jingchunqi09-sudo/Complexmusic/hardware/pinout.md

# 引脚表定案过程（3.5.6 → 3.5.10）

> 这份文档记录**唯一一个查不到的事实**（排线压接方向）是怎么靠实测反推出来的，
> 以及为什么 3.5.8 那份"上拉自洽性"论据不成立。以后不要再重复这三轮试错。

---

## 一、文件里能确定的部分（有几何验证，不是猜）

### 1. 转接板 U1（ESP32 30 针座）pad → GPIO

来自 `U1` 符号的 Pin Name，并用交叉项验证：

| pad | 9 | 10 | 15 | 17 | 18 | 19 | 20 | 21 | 22 | 23 | 24 | 25 |
|---|---|---|---|---|---|---|---|---|---|---|---|---|
| 引脚名 | D18 | D19 | D23 | VP | VN | D34 | D35 | D32 | D33 | D25 | D26 | D27 |
| GPIO | 18 | 19 | 23 | 36 | 39 | 34 | 35 | 32 | 33 | 25 | 26 | 27 |

**交叉验证**：`pad6=ESP_RX`、`pad7=ESP_TX` 落在 GPIO16/17，与本工程 UART2 完全一致；
`pad11/14=IMU_SDA/SCL` 落在 GPIO21/22，与 I2C 一致。列序可信。

### 2. 网络 → U1 pad（有走线几何验证）

PCB 段 `PAD_NET` 按 `COMPONENT` 顺序切分后，再用 `LINE` 走线端点坐标反查焊盘：

| 网络 | U1 pad | 几何验证 |
|---|---|---|
| `ENC1_A` | 9 | 走线端点 `(-50,-134)` 与 pad9 坐标**误差 0.0** |
| `ENC1_SW` | 19 | 端点 → pad19，误差 9.4（同一焊盘内） |
| `ENC4_SW` | 18 | 端点 → pad18，误差 0.8 |
| `ENC3_A` | H9 pad7 | 端点 `(450,-265)` 与 H9.pad7 旋转后坐标**误差 0.0** |

于是 `网络 → GPIO`：`ENC1_A=18 ENC1_B=19 ENC1_SW=34 / ENC2_A=23 B=25 SW=35 /
ENC3_A=26 B=27 SW=36 / ENC4_A=32 B=33 SW=39`。

### 3. 面板 U11 与转接板 H9 的针序（`PAD_NET`）

```
U11 pin1..14 : GND  1A   1B   1SW  2A   2B   2SW  3A   3B   3SW  4A   4B   4SW  GND
H9 pad1..14  : GND 4SW  4B   4A   3SW  3B   3A   2SW  2B   2A   1SW  1B   1A   GND
```

**H9 pad k 的网络名 = U11 pin 15−k**（整组反序）。

---

## 二、唯一查不到的事实：排线怎么压

两种 HC-2510 带防呆，排线只能是 1-1 或 1↔14 两种之一，**两个工程文件里都没有这个信息**。

### 3.5.8 用了"上拉自洽性"来判，这个论据是错的

当时的推理是：转接板 `R1..R4` 只上拉了 `ENCn_SW` 四个网络，而 GPIO34/35/36/39 没有内部上拉，
所以"同向排线让这四个脚正好落在有外部电阻的网络上，反序会出现 4 个悬空脚"。

**实际算一遍就知道两种接法完全一样**：`ENCn_SW` 四个网络对应的 GPIO 就是 34/35/36/39，
它们与排线方向**无关**；而 H9 与 U11 是整组反序，所以无论 1-1 还是 1↔14，
"面板的四个 SW" 都落到这四个网络上。**这条判据不区分任何东西。**

---

## 三、真正能判的：3.5.5 那版的实板现象

3.5.5 的表是 `ENC1=4/5/13, ENC2=18/19/21, ENC3=22/23/25, ENC4=26/27/32`，
其中 **4/5/13 根本没连任何 ENC 网络**（纯悬空），**21/22 是 I2C 的 IMU_SDA/SCL**。

把这个表分别套到两种排线上：

| 3.5.5 的组 | 同向 1-1 实际接到 | 反序 1↔14 实际接到 |
|---|---|---|
| ENC1 (4/5/13) | 三个死脚 | 三个死脚 |
| ENC2 (18/19/21) | 旋钮**4** 的 SW / B | 旋钮**1** 的 A / B |
| ENC3 (22/23/25) | 死脚 / 旋钮**3** 的 SW / B | 死脚 / 旋钮**2** 的 A / B |
| ENC4 (26/27/32) | 旋钮**2** 的 SW / B / 旋钮**1** 的 SW | 旋钮**3** 的 A / B / 旋钮**4** 的 B |

用户当时的原话：

> 有一个可以调节音色，第二个旋钮旋转一直会换弦，第三个调节的混响，第四个一直在旁路和混响那里切换

- **反序**：旋钮1→音色、旋钮2→换弦、旋钮3→混响、旋钮4→旁路 —— **与 1/2/3/4 的说法逐条对上**
- **同向**：旋钮1→旁路、旋钮2→混响、旋钮3→换弦、旋钮4→音色 —— **完全倒过来**

两条都没法解释"ENC1 全死"这一点（因为 4/5/13 在两种接法下都是悬空），
所以用户描述的四个旋钮，实际是 ENC2/3/4 加上"ENC4 被两个旋钮共用"的错觉。
**但功能顺序只有反序能对上**，这是唯一能判的硬证据。

---

## 四、结论（3.5.10 现行）

排线是 **反序 1↔14**，表为：

| 编码器 | A | B | SW |
|---|---:|---:|---:|
| ENC1（最左，音量） | 18 | 19 | 34 |
| ENC2（音色） | 23 | 25 | 35 |
| ENC3（定弦/换弦） | 26 | 27 | 36 |
| ENC4（最右，混响） | 33 | 32 | 39 |

`ENC4` 的 A/B 按用户核对结果为 33/32（符号读出是 32/33，只影响旋转方向）。

---

## 五、10 秒定死方法（3.5.10 新增自检）

网页新增「**面板接线自检**」卡片，显示 12 个 GPIO 的累计边沿数：

1. 点「清零后监视」
2. 转**最左**那颗旋钮
3. 看哪两个数在涨：
   - **18 / 19** → 反序（当前表正确）
   - **39 / 33** → 同向，需要把表整组换成 `39/33/32, 36/27/26, 35/25/23, 34/19/18`
4. 再按一下最左旋钮，看哪个脚掉到 0：
   - **34** → 反序
   - **32** → 同向

这一步跑完，这个变量就永远定死了，不需要再猜。
