jingchunqi09-sudo/Complexmusic/docs/left-hand-latency.md

> **来源（编者注）**
>
> 本文档原为 `左手选品参考代码/工程/docs/延迟上限_采样策略_琴弦材料_评估_20261027.md`，
> 该目录未随包分发。
>
> **为什么值得收进开源包**：这是左手采集链少见的定量分析——
> 5 ms 时隙的下限由 78 B 包的 UART 时间钉死（3.386 ms，占 68%）、
> 300→450 轮只涨 1.8 dB 而不降延迟、手掌 117 pF 对目标 3 pF 的 ~40 倍干扰比、
> 以及「换琴弦材料优先级最低」的反直觉结论。
> 这些数字是 `config/left_hand_detection.json` 取值的上游依据。
>
> 文中 `/d/left_hand_build` 为作者本地路径，仅作文档引用，不代表包内结构。

# 延迟上限、采样策略与琴弦材料 —— 评估报告

日期：2026-10-27
对应固件：`/d/left_hand_build`（46 kHz 载波 / 5 ms 时隙 / 230400 / LH/v2 78 字节包）

---

## 0. 结论摘要

| 问题 | 结论 | 关键数字 |
|---|---|---|
| 5 ms 时隙还能不能降 | **测试期不能**（下限由 78 B 包的 UART 时间钉死）；**判定进 FPGA 后能**，那时下限改由信噪比决定 | 78 B @230400 = **3.386 ms**，已占 5 ms 的 68% |
| 间隙里多采几轮 | **5 ms 里已经采满 300 轮、无空转**；但密度还能提 1.5×（SCLK 12.5 MHz）。**多采只涨信噪比，不降延迟** | 300→**450 轮**仅 +1.8 dB；延迟仍是 5~20 ms |
| FPGA 处理 + 选择性发送 | **方向完全正确**：终态不回 PC 后 UART 约束消失，时隙改由 SNR 决定。这一步要做的是把 `fret_map.py` 搬进 RTL | 包 78 B→16 B；测试期时隙下限 3.39→0.69 ms |
| 换琴弦材料（漆包线等） | **优先级最低，且漆包线有反向风险**。干扰主路径是手掌→背面的电容耦合，与弦材料无关 | 手掌 117 pF vs 目标 3 pF，干扰比信号强 ~40× |

**一句话**：先修模拟前端（背面屏蔽 → 弦高 → 驱动幅度），把信号从噪声底抬起来；再把判定下沉到 FPGA 并发 16 B 结果包；最后才考虑频分并行把延迟再砍一半以上。现在换弦材料不解决主要矛盾。

---

## 1. 延迟预算的真相

### 1.1 现状时间线（5 ms 时隙版）

```
时隙 k（5 ms）
├ 0 µs      ── 切弦（break-before-make 60 ns 空白）
├ 0-100 µs  ── SETTLE_TICKS=5000，ADC 不动
├ 100 µs-5 ms ── ADC 从 ch0 连续扫到 ch7，循环，共 300 帧
│                每帧 816 clk = 16.32 µs（16 通道顺序，每通道 102 clk）
├ 5 ms      ── slot_end，结算 mag[0..15]，打包发 78 B
└ 5 ms-8.39 ms ── UART 发完（与下一时隙的采集并行）
```

四弦分时 → 一轮 = 4 × 5 ms = **20 ms**。判定在 PC 端、当拍出结果，算法本身耗时 0.113 ms 可忽略。

所以按下到出结果的延迟 = **等待时隙 0~15 ms + 5 ms 累加 ≈ 5~20 ms**（平均 12.5 ms）。
用户实测"5 ms 也还行"，符合这个量级。

### 1.2 三重约束，按严重度排序

| # | 约束 | 当前值 | 怎么破 |
|---|---|---|---|
| 1 | **UART 包长**（仅测试期成立） | 78 B × 10 bit / 230400 = **3.386 ms** | 压包，或用更高波特率；终态不回 PC 后此约束消失 |
| 2 | **分时四弦** | 轮询 = 4 × 时隙 | 频分并行（每弦不同载波，但有前置条件，见 3.1） |
| 3 | **累加轮数 → 信噪比** | 300 轮（每相 75 轮） | 提高 SCLK（+52%）或换同时采样 ADC（×3~10） |

第 3 条容易被忽略但最要命：**缩短时隙 = 减少累加帧数 = 噪声按 √N 变差**。当前解调幅度空闲基线中位数只有 8~11（满量程 4095，约 −52 dBFS），说明信号链本来就紧，没有余量再牺牲平均。

---

## 2. 「5 ms 这么长的激励时间里，为什么不能多采几轮？」

先把三件被混在一起的事拆开：

| 事 | 由什么决定 | 影响什么 |
|---|---|---|
| **时隙长度** | 激励切换节奏（`EXC_SLOT_TICKS`） | **只决定延迟** |
| **时隙内的轮数** | 一轮时长（帧周期）× 可用时间 | **只决定信噪比** |
| **一轮时长** | 每轮要串行读几个通道 × SCLK 周期 | 同时影响上面两者 |

### 2.1 现状：5 ms 里确实已经采满了，但密度还能提

```
5 ms 时隙 = 100 µs 建立 + 300 × 16.32 µs（无空转）+ 0
100 µs + 300 × 16.32 µs = 4.996 ms
```

`adc_state` 在 `exc_count >= SETTLE_TICKS` 之后就进 A_XFER / A_HOLD / A_GAP 自循环，只有 `slot_end` 才停 —— 所以**没有空闲间隙，但也没到物理上限**。我上一轮说"300 帧是物理上限"是错的：那是**当前 SCLK 下**的上限。

一轮 16.32 µs 的构成：8 个通道时隙 × 102 clk，每个通道时隙 = 16 bit × 2 翻转 × 3 clk + HOLD 3 + GAP 3。瓶颈是 **8 个通道必须串行读完**（16 路靠 2 片 ADC128S102 同时转换，每槽 2 路，8 槽覆盖 16 路）。

### 2.2 轮数上限：三档提速

| 档 | 做法 | 一轮时长 | 5 ms 内轮数 | SNR 变化 |
|---|---|---|---|---|
| 0 现状 | SCLK 8.33 MHz | 16.32 µs | 300 | 1.00× |
| **1 免费** | `ADC_HALF_DIV 3→2`，SCLK **12.5 MHz** | 10.88 µs | **450** | **+1.8 dB** |
| 2 换 ADC | 16 路同时采样（AD7606 等），一轮 1 µs 级 | ~1-5 µs | 1000~5000 | 大幅 |
| 3 加片 | 更多 ADC128S102 并行 | 不变 | 不变（只加通道数） | 无 |

档 1 的代价：四相相干条件重解，载波只能取 `CARRIER_HALF=64`（390.6 kHz）或 `1088`（23.0 kHz）；12.5 MHz 是 50 MHz 时钟整数分频下能到的最高合法值（`ADC_HALF_DIV=1` 会到 25 MHz，超手册 16 MHz 上限）。

**注意档 1 的收益只有 +1.8 dB。** 因为噪声是 √N 关系，300→450 是 √1.5 = 1.22 倍幅度。而"降弦高 1.5→0.9 mm"是 +4.4 dB，"背面加接地屏蔽"可能消掉 39 倍共模源（+31 dB）。这就是为什么多采几轮不是当务之急。

### 2.3 关键澄清：多采几轮不降延迟

这一点最容易误会。**时隙末才结算一次发布**，所以：

```
延迟 = 等待时隙（0~3×时隙）+ 时隙（固定）
5 ms 时隙 → 5~20 ms，采 300 轮还是 3000 轮，都一样
```

想在 5 ms 窗口里多采，提高的是"这个结论有多可信"，不是"这个结论有多快出来"。**要跟手，必须缩时隙；缩时隙就要牺牲轮数。**两者是同一根杠杆的两端。

唯一能同时改善的办法是**让一轮变短**（档 2）：2 ms 时隙 + 每轮 1 µs = 1900 轮，既比现在的 300 轮多 6 倍，延迟还只有现在的 40%。这才是"并行采样"的真正价值。

### 2.4 终态（不回 PC）时隙下限要重新定义

用户已明确：**串口只是测试用的，最终结果留在 FPGA**。那么第 1.2 节里"UART 是硬约束"只在测试期成立。终态下：

```
时隙下限 = 建立时间(100 µs) + 最少轮数 × 一轮时长
UART 不参与，判定延迟也不参与（FPGA 内当拍出结果）
```

这带来一个重要结论：**测试期先别急着缩时隙**。现在 5 ms 之所以"还行"，是因为它刚好卡在 78 B @230400（3.39 ms）之上——再往下就会丢包，跟 SNR 无关。等判定进 FPGA、只发 16 B 结果包之后，时隙才可以按 SNR 的真实需要去选，而不是按串口带宽去选。

对应地，"FPGA 处理多轮采样、选择性发送"要做的事是：

1. **轮数不变**（还是 300 轮/时隙），在 FPGA 里把 300 轮合成 I/Q 幅度 —— 这已经是现在 `acc0..acc3` 在做的；
2. **判定也搬进 FPGA**：上电基线 + 逐极 Δ + 邻道比 + 阈值，输出"哪根弦第几品"；
3. **只在实际状态变化时**输出 8~16 B，或者干脆只点 LED，串口退化成调试口。

所以你说的这套东西，**架构上就是现在这套，只是把 `fret_map.py` 搬到 RTL 里**。它不会改变采样密度，但会解放时隙下限、去掉 PC 环节，并让"想采多少轮就采多少轮"变成真正可调的参数。

---

## 3. 降时隙的可行组合（含代价）

帧数 = (时隙 − 100 µs) / 16.32 µs；噪声倍数 = √(75 / 每相帧数)，以 5 ms 版为 1.00。

| 方案 | 时隙 | 包长/波特率 | UART 占用 | 帧数/每相 | 噪声倍数 | 轮询 |
|---|---|---|---|---|---|---|
| **现状** | 5 ms | 78 B @230400 | 68% | 300 / 75 | 1.00× | **20 ms** |
| A1 提波特率 | 3.5 ms | 78 B @460800 | 48% | 208 / 52 | 1.20× | 14 ms |
| A2 提波特率 | 2.5 ms | 78 B @460800 | 68% | 147 / 37 | 1.43× | 10 ms |
| **B1 结果包** | 2 ms | 16 B @230400 | 35% | 116 / 29 | 1.61× | **8 ms** |
| **B2 结果包** | 1.5 ms | 16 B @230400 | 46% | 86 / 22 | 1.87× | **6 ms** |
| B3 结果包 | 1 ms | 16 B @230400 | 69% | 55 / 14 | 2.33× | 4 ms |
| B3′ +ADC 提速 | 1 ms | 16 B @230400 | 69% | 82 / 21 | 1.94× | 4 ms |
| **C 频分并行** | 2 ms | 16 B @460800 | 17% | 116 / 29 | 1.61× | **2 ms**（有前置条件，见 3.1） |

读法：

- **A 组是纯参数改动**，不动协议、不动 PC 端，风险最低，但只能到 10 ms。
- **B 组是用户想的那条路**：判定进 FPGA，只发结果。16 B 结构建议：
  `4C 48 | ver=03 | seq | exc[3:0] | pad_hit[3:0]+conf | delta[11:0] | 邻居比[7:0] | crc16` → 刚好 16 B = 0.69 ms @230400。
  算法侧只需要"上电基线（4 弦 × 16 极 × 12 bit，768 bit BRAM）+ 逐极 Δ + 邻道比 + 阈值"，资源估算 2500~3500 LUT（当前 9935/59904，完全装得下）。
- **C 组理论上能同时拿到"20 ms 窗口 + 2 ms 延迟"**：四弦各用一个载波，同时激励、同时解调，轮询 = 1 × 时隙。**但它有一个前置条件，见 3.1，在未验证前不作为推荐路线。**

**推荐路线：B2（1.5 ms / 6 ms 轮询）先落地**，噪声只掉 1.87×，且保留了把 B 改成 C 的接口。

### 3.1 C 组（频分并行）的两个门槛

**门槛一（致命，先前已被否决过一次）**：分时方案里"哪根弦"靠**电学隔离**——只有一根弦被驱动，其余接地。一旦改成四弦同时驱动，判据就降级成"频率选择性"，隔离度从 −∞ 变成由**弦间桥接阻抗**决定。而用户实测"按中间两根弦最差、中间弦两侧都有邻居最严重"，恰恰说明**手在桥接相邻弦**。桥接一旦成立，1 号弦的载波会经手指灌进 2 号弦，2 号弦的解调结果里混着邻弦信号 —— 频分并行在这种条件下会直接失去分弦能力。

所以 C 组的**前提条件**是：先通过弦间绝缘（Kapton 隔片 / 局部护套 / 弦距拉开）把弦间直流与低频阻抗提到足够高，并且用数据集验证"单弦桥接量"可接受。这个前提不成立，C 组不能用，只能留在 4×时隙的框架里。

**门槛二（工程性）**：ADC 每通道的等效采样率恰好等于帧率 **61.27 kHz**，所以载波必须取帧率的整数倍才能在 N 帧上正交（矩形窗 DFT，整数 bin 之间严格正交，无泄漏）：

- 可用集合 `{1,2,4,8} × 61.27 kHz` = 61.3 / 122.5 / 245.1 / 490.3 kHz —— **谐波互不重叠**（方波只有奇次谐波，这个集合的奇次倍集两两不相交）。
- 不能用的：`{1,2,3,4}` —— 1 号弦的 3 次谐波正好落在 3 号弦的 bin，串扰 −9.5 dB，致命。
- 490 kHz 已在 TIA 极点（482 kHz）之上，会衰减 3 dB 并抬高辐射耦合，实际可能要退成 **2 弦并行 + 2 时隙**（轮询 = 2 × 时隙 = 4 ms，C 组一半的收益，但只增加 2× 解调资源、载波只用 61/122 kHz）。

代价：解调资源 ×4（16 ch × 4 相 × 4 频 = 256 个 24 bit 累加器），以及激励端方波的高次谐波会经弦-极非线性（手指接触的金属-氧化物接触）产生互调，落点是待验证项。

---

## 4. 琴弦材料：定量分析

### 4.1 三个可能的动机，逐个算

**(a) 让弦-铜极耦合更强 —— 无收益，甚至略负**

漆层 40 µm、εr≈3.5，等效把间距 d 缩短 40 µm 又拉长 40/3.5≈11 µm，净变化 ≈ −29 µm。若原间距 1.5 mm，C 变化 **+2%**。噪声底级别的差异。

**(b) 切断手的欧姆通路 —— 取决于手接触电阻，可能反向**

漆包线把"裸线欧姆接触"换成"串联介质电容"。手指压弦接触面积按 5 mm × 1.2 mm、漆层 40 µm 估：

```
C_enamel = ε0·εr·A/d = 8.854e-12 × 3.5 × 6.0e-6 / 40e-6 ≈ 4.65 pF
Z @46 kHz  = 1/(2π·46k·4.65p) ≈ 744 kΩ
Z @260 kHz = 1/(2π·260k·4.65p) ≈ 132 kΩ
```

判据很干脆，**用万用表量一下手指压弦时弦到人体的直流电阻**：

| 实测手-弦接触电阻 | 换漆包线后干扰 | 结论 |
|---|---|---|
| < 100 kΩ（湿手、用力按） | 744 kΩ ≫ 原值 → 干扰降 7~70× | **有显著收益** |
| ≈ 500 kΩ ~ 1 MΩ（干手、轻按） | 744 kΩ ≈ 原值 → 基本不变 | 无收益 |
| 干手 + 高载波（260 kHz） | 132 kΩ < 1 MΩ → 干扰反而 +7× | **反向，别换** |

也就是说：漆包线是不是好主意，**完全取决于这个还没测的数**。这是第一个该去量的东西。

**(c) 降低弦的 AC 电阻（趋肤效应）—— 46 kHz 下可忽略，260 kHz 下才有意义**

```
δ_钢(μr≈100, 46k)  ≈ 91 µm     R_ac/R_dc ≈ 1.1
δ_铜(46k)          ≈ 304 µm    R_ac/R_dc ≈ 0.8（全截面导通）
δ_钢(260k)         ≈ 38 µm     R_ac/R_dc ≈ 2.6
```

46 kHz 下钢弦和铜弦差别 30% 以内，而驱动串的是 220 Ω，这点差异被完全淹没。**真要换材料，换裸铜/黄铜/镀银铜比换漆包线有意义**（前提是 260 kHz 版）。

### 4.2 为什么换弦材料治不了「按一根四根全亮」

手的干扰有两条路：

1. **手 → 被驱动的弦 → 所有铜极**（经弦-极电容，同相位 → 共模）
2. **手（尤其手掌）→ 隔着 PCB → 铜极背面**（直接电容耦合）

算第 2 条：手掌 80×60 mm、FR4 1.6 mm、εr 4.4

```
C_palm ≈ 8.854e-12 × 4.4 × 4.8e-3 / 1.6e-3 ≈ 117 pF
```

对比目标信号（弦-极 3 pF）：

```
117 pF : 3 pF = 39 : 1
```

**手掌耦合比目标信号强约 39 倍**，而这条路径 **完全不受琴弦材料影响**。这才是"四根弦全亮"最可能的物理主因，也更符合"整片一起亮"而不是"某几极亮"的现象。

结论：换弦材料最多改善路径 1，而路径 1 大概率不是主因。

### 4.2.1 现场发现（2026-10-27）：本次 PCB 铜极裸露，上一版有阻焊漆

用户反馈：**上一块测试板铜极上有一层漆（阻焊），这次的铜极是裸露的**。这一条差异的影响远大于换弦材料，需要单列。

两种状态对手部接触的性质完全不同：

| | 有阻焊漆（25 µm，εr≈4） | 裸铜 |
|---|---|---|
| 手指与铜极 | **无欧姆接触**，只能经串联电容 | **直接欧姆接触**（干手 10 kΩ~1 MΩ，出汗后 1~50 kΩ） |
| 接触阻抗性质 | 线性、固定、可预测 | 非线性、随压力/湿度/氧化剧烈漂移 |
| 直流/低频通路 | **完全阻断** | 打通：体电位、汗液电化学电位直接注入 |
| 对 46 kHz 载波 | 串联 142 pF → Z≈24 kΩ，**基本挡不住** | 接触电阻分压，注入更强 |
| 长期稳定性 | 铜被封闭，不氧化 | 生成 Cu₂O/CuO 半导体层，**整流接触** |

先算清"漆层到底值多少"：

```
手指接触面积按 1 cm²、阻焊 25 µm、εr 4.0
C_mask = 8.854e-12 × 4.0 × 1e-4 / 25e-6 ≈ 142 pF
Z @45.956 kHz = 1/(2π·45956·142e-12) ≈ 24.4 kΩ
```

**所以必须诚实地说：漆层挡不住 46 kHz 的电容耦合**（24 kΩ 对 100 pF 的人体对地阻抗是同一个量级）。它的真正价值不在载波频率上，而在于**把另外三条通路整条切断**：

1. **欧姆注入**：裸铜时手指直接接到运放虚地节点，人体上的 50 Hz 感应电位（可达 V 级）以接近零阻抗打进求和节点。这不是"共模"，是"直驱"。
2. **电化学**：汗液（NaCl 电解质）里的铜产生几百 mV 的伽伐尼电位和 CuCl 沉积，接触电阻随出汗量随机游走 —— 等效给每个通道加了一个**随机的时变增益**。
3. **非线性整流**：Cu/Cu₂O/皮肤 构成金属-氧化物-半导体结，对方波载波整流，产生直流偏移与偶次谐波。**共模扣除的前提是"线性可加"，这一条直接让该前提失效** —— 这是算法层面无论如何也补不回来的。

而裸露铜极换来的耦合增益是多少？

```
等效空气间距净减少 = 25 × (1 − 1/4.0) = 18.75 µm
弦-极间距按 3 mm 算 → 耦合只增加 18.75/3000 ≈ 0.6%
```

**0.6~0.9% 的耦合增益，换来欧姆注入 + 电化学 + 非线性三条干扰通路，这是一笔亏本交易。** 如果当初是为了"让耦合更强"才去掉阻焊，方向搞反了。

对应的零成本验证（10 分钟）：

> 在现有裸铜板上贴一层 **Kapton 胶带 / 聚酰亚胺胶带 / 普通透明胶带（PET，50 µm）**，再做同一套按压测试。若手部影响明显下降，即锁定这条原因，且同时说明 §4.3 的"正面绝缘层"优先级要提到第 1 位。

注意：这里说的是**正面（朝弦那面）薄绝缘层**，与背面导电屏蔽层是两件事、位置相反、作用互补，都要做。

**覆盖材料对比（手指接触 1 cm²，载波 45.956 kHz）**

覆盖层厚度 t、εr 时，手指经该层的串联电容与阻抗：

```
C = ε0·εr·A/t          Z = 1/(2πfC)
弦-极等效间距净变化 = −t(1 − 1/εr)   （负号表示耦合略增）
```

| 材料 | 厚度 | εr | 串联 C | Z@46 kHz | 弦-极耦合损失（d=3 mm） |
|---|---|---|---|---|---|
| 裸铜（现状） | — | — | — | **欧姆 ≈10 kΩ（湿手）/ 1 MΩ（干手）** | 0 |
| 阻焊漆（标准） | 20 µm | 4.0 | 177 pF | **19.6 kΩ** | 0.5% |
| 阻焊漆（双层上限） | 40 µm | 4.0 | 88 pF | 39 kΩ | 1.0% |
| Kapton / 聚酰亚胺 | 25 µm | 3.4 | 120 pF | 29 kΩ | 0.6% |
| PET 透明胶带 | 50 µm | 3.2 | 57 pF | 61 kΩ | 1.1% |
| **PVC 电工胶带** | 150 µm | 3.5 | 21 pF | **168 kΩ** | 3.6% |
| 电工胶带 ×3 | 450 µm | 3.5 | 6.9 pF | **503 kΩ** | 11% |

**关键结论：覆盖层越厚，挡手越好，而弦-极耦合几乎不掉**（因为弦在覆盖层上方，覆盖层只是把一小段空气换成介质，等效间距反而缩小）。所以 3 层电工胶带能把手的耦合阻抗从 10 kΩ 抬到 500 kΩ（50 倍），代价只是弦-极耦合降 11%。

**为什么阻焊漆在载波频率上先天赢不了**：它的厚度被 PCB 工艺钉死在 **20~40 µm**（一次丝印 UV 固化），再怎么优化也只能到 39 kΩ，是 3 层胶带的 1/13。而胶带可以任意叠加。但阻焊漆在另一件事上先天赢：**共形、无缝、与铜化学键合**，手指按压挤不出缝、汗液渗不进去，而胶带最怕的正是这个。

**一个反直觉的推论**：46 kHz 上，干手直接压裸铜（接触电阻 ~1 MΩ）的耦合阻抗，其实**比 20 µm 阻焊漆（19.6 kΩ）高 50 倍**。也就是说，就"挡载波"这一项，薄的阻焊漆不如干燥的裸铜。阻焊漆真正的价值在直流侧：切断汗液电化学、伽伐尼电位、Cu₂O 整流非线性 —— 这三条是裸铜的致命伤。所以**两者不是替代关系，是分别对付两个不同机理，必须叠加使用**。

电工胶带使用的三个注意点：

1. **静电荷**：PVC 摩擦起电很强，撕开时可达 kV 级。虚地节点上是 330 kΩ 跨阻，静电能直接把运放打饱和。贴好后先用手摸一下地释放，再上电；**不要反复撕贴**。
2. **增塑剂**：PVC 含增塑剂，会迁移并腐蚀裸铜，也随频率/温度改变 εr。定性验证没问题，**做定量对比实验请换 Kapton**。
3. **边缘缝隙**：手汗会从胶带边缘渗到铜极，必须整条盖住并压实，两侧多留 2 mm。

### 4.3 硬件改动优先级（按效果/成本）

| 优先级 | 改动 | 预期效果 | 成本 |
|---|---|---|---|
| **1** | **铜极正面贴薄绝缘层**（阻焊 / Kapton 25~50 µm） | 切断欧姆注入、电化学、非线性整流三条通路；目标信号只损 0.6~0.9% | ≈ 0（贴胶带即可验证） |
| **1** | **铜极背面加接地屏蔽层**（顶面铜极、背面整片地，或加一层薄铜箔接地） | 直接消掉 39× 的共模源，同时固定 C 到地、不改信号 | ≈ 0（飞铜箔 + 接地即可验证） |
| **2** | **缩小弦-铜极间距**（降弦高 / 铜极垫高） | 信号 ∝ 1/d，1.5→0.9 mm 即 **+67%** | 低 |
| 3 | 铜极周边驱动保护环（guard ring） | 抑制极间串扰、抑制手在极间缝隙的耦合 | 中（改 PCB） |
| 4 | 驱动幅度 3.3 V → 5 V（74HCT125 替代 LVC125） | +3.6 dB，直接抬信号 | 低，但要确认 OPA4350 输入不饱和 |
| 5 | 每品双半极差分读出 | 共模抑制 ~20 dB，但极数翻倍、走线翻倍 | 高（改 PCB） |
| 6 | 换琴弦材料 | 见 4.1，取决于未测的手电阻；漆包线有反向风险 | 低，但**最后做** |

---

## 5. 建议的动作顺序

1. **先测三个数**（10 分钟，万用表即可）：
   - 手指压弦时，弦到人体的直流电阻；
   - 手掌贴在琴颈背面时，铜极到人体的电容（或用已知电容串接法估）；
   - 现在的铜极背面是否已有完整地平面。
2. **飞铜箔做背面屏蔽实验**，用现有 5 ms 固件采集对比数据集 —— 这一步的预期收益比任何固件改动都大。
3. **降弦高**到 1.0 mm 以内，再采一轮对比。
4. 信号抬起来之后，再上 **B2 固件**（FPGA 判定 + 16 B 结果包 + 1.5 ms 时隙 → 6 ms 轮询）。
5. 只有在 6 ms 仍不够跟手、**并且**弦间桥接已被证明可忽略时，才考虑 **C 组频分并行**（门槛不满足则退成保守版：2 弦并行 → 4 ms，或干脆不并行）。

---

## 6. 待验证 / 风险

- 手接触电阻的真实量级（决定漆包线是否有意义，也决定干扰模型的系数）。
- 背面加地后，TIA 输入端对地电容增大会抬噪声（OPA4350 噪声增益 ∝ 1 + Cs/Cf），需实测本底是否恶化。
- B 组的基线漂移：上电基线 + 是否要做慢速跟踪（温漂、换弦），需要定更新速率与死区。
- C 组的互调串扰：手指接触的金属-氧化物非线性会在两个载波的和差点产生互调，落点正好是别的 bin。
- 1 ms 级时隙下工频抑制彻底失效（5 ms 才 0.25 个 50 Hz 周期），50 Hz 与 100 Hz 环境干扰会整片抬底噪 —— 这与"降延迟"是同向恶化，只能靠差分/屏蔽解决，不能靠平均。
