jingchunqi09-sudo/Complexmusic/docs/R54-review.md

# 多模型评审：R54 尤克里里弦指引（两轮）

> 上下文见脚本 scripts/review_r54_uke_guide.py

---

# 第 1 轮 交互设计评审

## 千问（qwen3.8-max）

A1  
首选 (c)+(b)：目标行整行 30 px 高对比色带，叠加最左空弦块实心填充。周边视觉对大面积水平亮带和左侧锚点最敏感，比 2 px 弦线或右端小三角更容易一眼抓到。色带用半透明但提高亮度，避免完全盖住品格信息。

A2  
只靠 `i_instruments[row] & i_gates[row]` 不够可靠。gate 可能因保持/释放未落导致“一直绿”，也可能因声部分配或弱触发导致“永远不绿”。更稳是：guide 有效 + 该行 instrument + `i_gates` 上升沿/短窗内有效，最好再叠加弦能量包络；若不能加新源，至少做 gate 边沿去抖和超时熄灭。

A3  
不建议更快。uke 信息量少，快闪会变成噪声并干扰余光定位。推荐“出现时短闪 2~3 次，然后常亮或慢呼吸”；若必须持续提示，用比现有更慢的闪烁。

A4  
会有误导，另外三行会被误读成也要按。应在 uke 指引生效时把非目标行压暗/去饱和，并保留琴颈轮廓即可。不要完全隐藏，避免切回小提琴或同屏混合时产生跳变。

A5  
最可能“指错弦”：逐条点亮 lane4..7，确认只有对应行和左块响应。其次“命中判据不准”：在开弦、闷音、持续音下比对绿色出现与实际发声。第三“压暗影响小提琴读谱”：关闭/切走 uke 指引，确认原品丝边框和命中色仍可辨。

## Kimi（kimi-k2.7-code）

**A1**  
推荐以 (a) 为主，再叠加 (b) 的左侧空弦块实心闪烁：全行弦线高亮给出长水平指示，最左边缘块提供强对比闪烁。2–3 m 余光对大长度+边缘运动最敏感。不用 (d)（太小），不用 (c)（半透明带会遮挡同排信息并引入混色逻辑）。

**A2**  
“该弦 gate 有效”基本可用，但会因 sustain/drone 导致“一直绿”，也会因 gate 太短或行映射错误而“永远不绿”。更稳的做法是在 guide_valid 且 lane==row 期间，用寄存器记录一次 gate 命中并保持可见数帧。i_instruments[row] 仅作该行确实是 uke 的校验，不直接作为命中判据。

**A3**  
保持现有 8 帧（约 7.5 Hz）闪烁。Uke 目标已是整行，面积大，现有频率足够抓眼；更快易疲劳，取消闪烁则会丢失动态提示。

**A4**  
会误导，建议压暗其余三行。当 uke 指引有效且 lane 匹配时，把非目标行亮度降到约 50% 或去饱和灰化，只保留目标行高亮。

**A5**  
- “目标弦不亮或常亮”：用逻辑分析仪核对 i_gates[row] 与 guide_valid/lane 的对应时序。  
- “高亮太弱/太刺眼”：在 2–3 m 实际距离与演出光照下主观确认。  
- “其他行仍有品位，分散注意”：验证非目标行是否随 uke 指引同步压暗。

## DeepSeek（deepseek-chat）

**A1** 选 (b)+(d) 组合，但以 (b) 为主。2~3 米站姿下，眼睛对"实心色块"和"运动/边缘对比"最敏感，(a) 长横线在 4 行同构纹理里辨识度低，(c) 半透明带在强屏反光下会糊掉。推荐：x=4..20 空弦块实心填充（高亮色，比弦线亮一档），同时该行弦线加粗到 4 px 并短暂闪一次；(d) 三角指针可作辅助但单靠它太小、远处看不见，不建议单用。核心是"块+粗线"形成 L 形对比锚点。

**A2** 判据不可靠。i_gates[row] 是"该弦正在发声"，但余音/串音会让它一直绿；uke 空弦时用户手指刚离弦 gate 就掉，会"闪绿即灭"，看起来像没绿过。更稳的判据：i_gates[row] 上升沿后锁存一个 ~300 ms 的"命中窗"，窗内显示绿色；窗内再次 gate 刷新。另外用 i_instruments[row] 确认该行确实是 uke 才启用此逻辑，避免小提琴行误绿。

**A3** 不闪，只改颜色/亮度。uke 信息量只有"哪根弦"，闪烁反而干扰"正在弹哪根"的持续可读性；小提琴闪是因为要在 16 个品位里定位一个移动目标。建议：未命中=琥珀常亮，命中=绿色常亮（带 A2 的命中窗），命中瞬间可加 1 帧亮白提亮作为"打点"，但不做周期翻转。

**A4** 会误读。必须压暗另外 3 行，但要压得"可辨不可抢"：把非 uke 行的弦线/品丝降亮度约 40%、去掉高亮边框，uke 行保持原亮度并加指引色。不要全黑，否则布局突变会让老用户以为换页了。压暗只作用于 uke 指引生效期间（i_guide_lane>=4 且 valid），退出即恢复。

**A5**
1. "uke 行亮了但另外三行还在动，我以为要按"——验证：uke 指引生效时截图，看非 uke 行亮度是否明显低于 uke 行。
2. "弹完一直绿/刚弹就灭"——验证：单弦连拨 3 次，观察绿色持续是否覆盖每次拨弦到下一次拨弦的间隙。
3. "远处看不清是哪根弦"——验证：2.5 m 处 1 秒内指认高亮行，正确率应 >90%；不达标就加大空弦块或加粗弦线。

---

# 第 2 轮 代码与时序评审

## 千问（qwen3.8-max）

B1：不能依赖合并。只有当 `uke_row` 与现有 `nr` 是同一根已寄存网络且表达式完全相同，才可能被优化合并；否则会新增加法/比较逻辑，确实会拉长 neck 组合路径。当前余量下不要新增该计算，应复用现有 `ncy/row`，或预寄存/ROM 化。

B2：会覆盖小提琴框。若协议明确 `lane=4..7` 是 ukulele，则符合预期；正常不会覆盖 `lane<4`。风险是 `i_guide_lane` 异常、mode/乐器状态不匹配时误覆盖。建议加显式范围/乐器门控，否则最后优先级不安全。

B3：不是零风险。`i_instruments/i_gates` 新增扇出、索引 mux 和布线，即使逻辑很小，184 ps hold 下也可能炸。零风险写法只有不新增读取：固定目标色/只闪烁，或复用已有寄存好的单 bit hit；必须判命中时先在 50M 域寄存。

B4：不新增顶层端口只能降低风险，不等于安全。改动 C 仍会新增内部 net、扇出和布局扰动。意外来源：dashboard 内部新逻辑、`i_instruments` 新扇出、调试探针/约束、隐式位宽转换、跨层级共享译码。需以后布线结果确认。

B5：把 `uke_hit` 硬接 0 并保留琥珀色，会像“永远未命中”，体验不佳。折中：第一版改成单一目标色或仅闪烁，不做命中判定；命中色等已有寄存 hit 或下一拍寄存版本验证后再接入。

## Kimi（kimi-k2.7-code）

B1：别指望合并。等效 *40 的进位链在 hold 只剩 184 ps 时极易因布局漂移被顶炸。应复用已有的 `row_y/yc`；若必须新建，与坐标同拍寄存，或干脆用 4 值 `case` 常量查表，彻底去掉加法器。

B2：lane 切分正确，`lane[2]` 区分小提琴/尤克里里，不会误覆盖小提琴。但 uke 分支优先级最高，会把同格小提琴边框盖住；符合预期就保留，否则改成 `else if` 链。y 范围与现有实现一致。

B3：i_gates/i_instruments 再多一个 4 选 1 负载，逻辑量很小，但 hold 极紧时不是零风险。**应先把 `uke_hit` 在 pixel/logic 域打一拍**，颜色级只读 1 bit 寄存器，不要在组合路径上直接索引总线。

B4：不新增顶层端口比新增端口安全得多，但不是绝对零风险。dashboard 多一根输入会改变子模块布线和负载；若 `i_instruments` 来源较远，建议在 `hdmi_instrument_display` 内打一拍再送入 dashboard，并确认 dashboard 没有产生新的跨时钟路径。

B5：只闪 amber 能用，但缺少命中反馈，会显得半成品。折中：按 B3 做一个 1 bit 寄存命中信号 `uke_hit_r`，既保留绿/琥珀反馈，又把组合路径和扇出风险压到最低。

## DeepSeek（deepseek-chat）

**B1** 综合器通常能把同表达式的移位加合并（CSE），但**不保证**跨 always 块、跨层级（ncy 在别处、uke_yc 在新块）一定合。风险点不是"多一级加法"，而是 uke_yc 成为 neck_c 组合链的**新输入支路**——它前面挂着 lane 解码 + 两个加法。给出结论：不要依赖合并，**直接把 uke_yc 打一拍**（用已有的 x1/y1 同拍节拍寄存），把 40*row 的加法挪出比较链。这样比较器只吃寄存器，链路长度与现有一致。

**B2** 放最后=优先级最高，会覆盖小提琴框。判断：`i_guide_lane>=3'd4` 与已有的 `i_guide_lane<2'd4` **互斥**（3'd4 起才进 uke，<4 走 violin），不会互相覆盖。但注意 `i_guide_lane` 是 3 位，若上游可能送 5/6/7，uke_row = lane[1:0] 会折回 0/1/2/3 —— **必须确认 lane 只会是 0..7 且 4..7 合法**，否则折回串行。建议 uke_on 加 `i_guide_lane<=3'd7` 显式守护。符合预期。

**B3** hold 风险低但非零：是两个 4 位与 + 一个 2 选 1 进颜色多路，都在 pixel 域已寄存信号的扇出末端，深度浅。**零风险写法**：把 `uke_hit` 提前在 guide 更新那一拍寄存成 1 位（跟 guide_lane/fret 同拍），B 里直接读寄存器。多 1 个 FF，不新增端口，组合链不增长。

**B4** 改动 C 安全（模块内连线，端口表不变）。**意外跨模块连线风险点**：① 若 dashboard 里又把 i_instruments 扇出给新子模块实例，等于新增跨模块网；② uke_on/uke_hit 若在多个 always 块引用，综合可能复制逻辑并拉动布局；③ 新增 24'h 常量颜色若走 LUT 新增 slice。规避：uke_hit 寄存化、uke_on 只在一处用、颜色复用已有常量。

**B5** 只闪不判命中不傻——**引导框本身就是提示**，"命中反馈"是加分项。折中：**闪琥珀恒亮**（uke_on && guide_blink 显示 E9B353），命中绿留到下一版；或**用 i_fret_bus[lane*5+:5]==guide_fret 判命中**（该信号已在用，B3 零风险），不必等 i_gates/i_instruments。推荐后者：既有命中反馈又不碰 gates 扇出。
