jingchunqi09-sudo/Complexmusic/docs/images/evidence/工作台_弦与定弦_面板自检.jpg

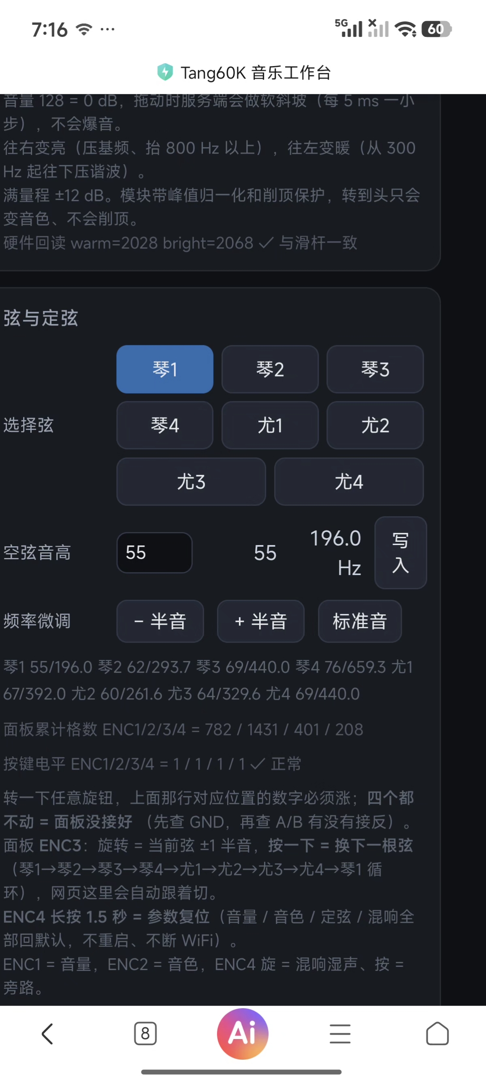
docs/images/evidence/工作台_弦与定弦_面板自检.jpg
