jingchunqi09-sudo/Complexmusic/docs/images/photos/TangMega60K_核心板.png

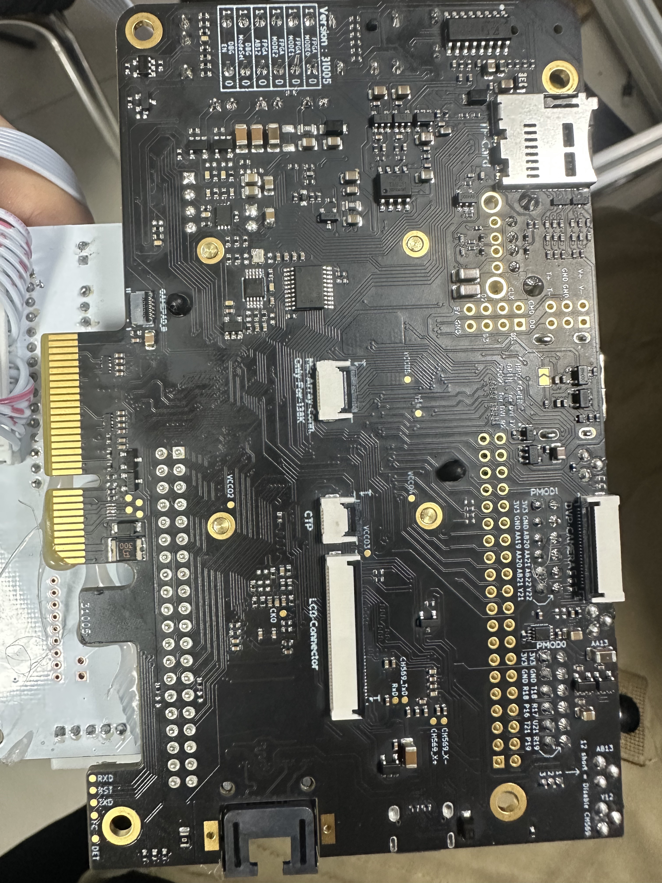
docs/images/photos/TangMega60K_核心板.png
