jingchunqi09-sudo/Complexmusic/docs/images/photos/TangMegaNEO_底板.png

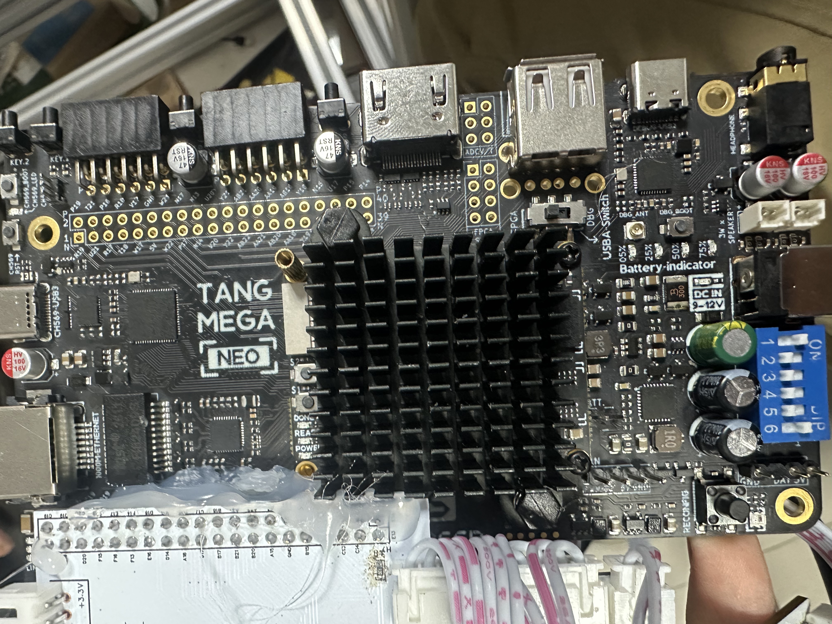
docs/images/photos/TangMegaNEO_底板.png
