jingchunqi09-sudo/Complexmusic/firmware/docs/手机端界面预览.png

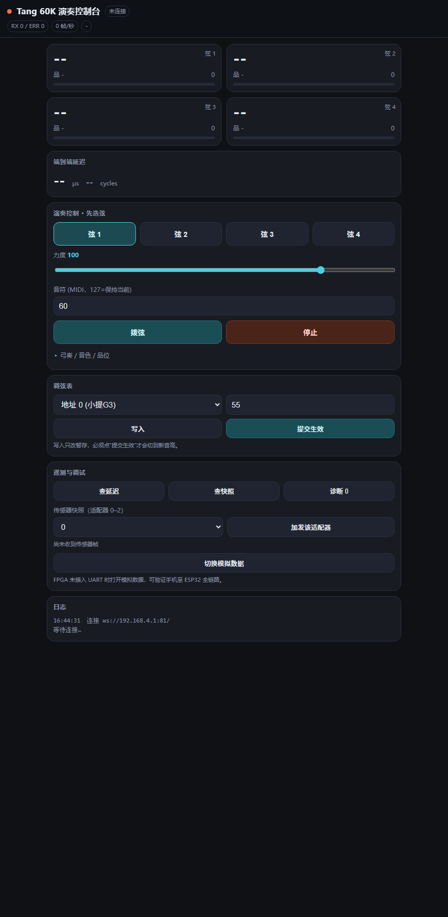
firmware/docs/手机端界面预览.png
