jingchunqi09-sudo/Complexmusic/hardware/bow-module-3d/bow_sensor_module_dimensions.csv

id | feature | value | unit | status | source_or_note
BOW-01 | 弓杆名义外径 | 10.0 | mm | 初始占位 | 必须用实际弓杆在安装位置测量
BOW-02 | 夹壳内孔直径 | 10.6 | mm | 初始占位 | 给0.6 mm装配余量；按实物改
BOW-03 | 夹壳沿X长度 | 30.0 | mm | 初始占位 | 比例草案
BOW-04 | 夹壳外宽Y | 18.0 | mm | 初始占位 | 不含pod
BOW-05 | 夹壳总高Z | 18.0 | mm | 初始占位 | 分体结构包络
BOW-06 | pod外包络X | 28.0 | mm | 初始占位 | 不含线缆弯曲半径
BOW-07 | pod外包络Y | 18.0 | mm | 初始占位 | 含外壳圆角
BOW-08 | pod外包络Z | 10.0 | mm | 初始占位 | 需按镜头座/PCB复核
BOW-09 | PCB厚度 | 1.60 | mm | 资料参考 | 项目PMW3360指南首版参考
BOW-10 | 光学窗口到跟踪面的Z距离 | 2.2–2.6 | mm | 资料确定 | PMW3360手册推荐工作距离Z
BOW-11 | 窗口初始开口X | 6.0 | mm | 初始占位 | 按实际镜头光窗修改
BOW-12 | 窗口初始开口Y | 4.0 | mm | 初始占位 | 按实际镜头光窗修改
BOW-13 | 横向夹紧螺钉中心距 | 20.0 | mm | 初始占位 | 需避开镜头/PCB
BOW-14 | 参考条宽度 | 12.0 | mm | 初始占位 | 独立固定件，不属于弓
BOW-15 | 参考条厚度 | 3.0 | mm | 初始占位 | 先用于空间关系
BOW-16 | 线缆出口后方直段 | 12.0 | mm | 初始占位 | 需按线缆弯曲半径复核
BOW-17 | 外壳最小圆角 | 1.5 | mm | 初始占位 | 打印/铣削友好建议
BOW-18 | 接口信号 | 5V_IN;GND;SCLK;MOSI;MISO;NCS |  | 资料参考 | 项目PMW3360指南六线定义
