jingchunqi09-sudo/Complexmusic/hardware/bow-pcb-guide.md

# PMW3360 琴弓传感器 PCB 画板指南

日期：2026-10-05。适用：PMW3360DM-T2QU 裸芯片及配套透镜、Tang Mega 60K 核心板、Tang Mega NEO 底板。本文是供画原理图与首版 PCB 使用的设计建议；未创建 EDA 工程、未执行 ERC/DRC、未打样、未测板，也未修改 FPGA 源码或约束。

依据 PMW3360 v1.50 手册，以及 Tang_Mega_NEO_Dock-60K_31004_Schematics.pdf（Rev1.4，2025-03-31）。138K_31005 图纸用于对照，不能替代 60K 的物理针脚定义。上述资料**未随本仓库分发**，请从厂商官网获取。

## 1. 先确定光学结构

PMW3360 输出相对于跟踪表面的 ΔX/ΔY，不能在没有近距离纹理表面的空气中测出自由挥弓速度。它不是 IMU，也不直接测量弓压、弦号或到琴桥的距离。

建议先做一个可保持间隙的台架：固定传感器板，令弓上的平整纹理条沿 X 轴经过镜头。也可让传感器随弓移动、面对固定纹理面。两种安装方式的方向符号须实测标定。若直接对弓毛、圆弧弓杆、细琴弦或光亮漆面取像，能否稳定跟踪需要先试验；不能仅由芯片速度规格推断成功。

手册第1页推荐 LM19-LSI。第6页 Figure 4 与第14页 Table 3：Z 是镜头法兰底面到跟踪表面的距离，典型 2.4 mm、推荐 2.2–2.6 mm。这不是 PCB 到表面的距离，也不是可任意变化的工作距离。参考机械图使用 1.60 mm PCB；首版可沿用这一板厚，再依据实际透镜导向柱、定位孔与壳体作尺寸检查。

先核对已购透镜型号、实物尺寸和安装方向，然后按手册第4–10页建立专用封装、机械开孔和禁布区。不要直接套普通 DIP-16/SOIC-16 封装；芯片的 Pin 1、镜头定位柱及焊接面的视图必须一致。镜头光路和安装空间内不要放元件或裸露铜面。

## 2. 推荐电源和外部接头

首版使用六线：5V_IN、GND、SCLK、MOSI、MISO、NCS。PCB 上分成两路 LDO，采用手册第12页参考拓扑：

```text
5V_IN ── LDO_A，3.3 V ── VDDIO（芯片5脚）、接口上拉
       └ LDO_B，约1.9 V ─ VDD（芯片4脚）、LED供电支路

芯片3脚 VDDPIX ── 4.7 µF ∥ 100 nF ── GND
                  内部LDO输出，不接外部供电
```

**VDD 推荐 1.80–2.10 V，典型 1.90 V；不可接 3.3 V 或 5 V。VDDIO 推荐 1.80–3.60 V，且不得低于 VDD。** 本方案令 VDDIO=3.3 V，以匹配项目默认 3.3 V 的扩展 IO。采用两路同源电源，上电仍须核对手册第26页的两轨间隔≤100 ms与第14页电源上升时间要求。

如果复用第12页的 TPS73601DBVR 可调 LDO，两路均为：1脚IN接5V_IN，2脚GND，3脚EN接5V_IN，4脚FB接反馈中点，5脚OUT输出。参考元件：

| 支路 | OUT→FB 上电阻 | FB→GND 下电阻 | IN→GND 输入去耦 | OUT→FB 前馈电容，跨上电阻 | OUT→GND 输出电容 |
|---|---:|---:|---|---|---|
| 3.3 V（U1） | R14，52.3 kΩ | R16，30.1 kΩ | C15=100 nF、C17=1 µF | C19=100 nF | C21=10 µF |
| 约1.9 V（U2） | R15，37.4 kΩ | R19，63.4 kΩ，J5档位 | C16=100 nF、C18=1 µF | C20=100 nF | C22=10 µF |

2026-10-05按原图连线复核修正：C19/C20并非OUT对地电容，而是OUT到FB的前馈电容。C21/C22才是参考图的LDO输出对地电容。传感器侧另外有C12/C14、C23/C24对地电容，容量见下节；它们也是手册参考元件，不能与C19/C20混为同一个器件。

TPS73601的内部反馈基准典型值为1.204 V。稳态时LDO调节输出，使FB点接近这个基准；因此 VOUT≈1.204×(1+R上/R下)。1.9 V档的计算是1.204×(1+37.4/63.4)≈1.914 V，参考图按约1.9 V标注。电容在稳态直流分析中视为开路，不参与这组分压比；C20作用于噪声与动态响应，C22提供输出去耦及负载变化时的储能。这些电阻是LDO反馈分压，不是用输入5 V电阻分压直接给芯片供电。

布局时让反馈电阻及C19/C20靠近FB与OUT，反馈回路尽量短；C21/C22靠近LDO输出与地，输入电容靠近IN与地。传感器4/5脚分别配10 µF与100 nF对地电容，3脚配4.7 µF与100 nF对地电容，具体连接见下节。

这些阻值来自参考图的相应档位；选用1%电阻，电容优先 X7R/X5R，5 V输入电容耐压至少10 V。若更换 LDO 型号，需重新核对管脚、反馈基准和稳定性所需的电容，不能保留这组电阻后直接换料。去耦靠近相应电源脚；较远的 LDO 输出电容不能替代芯片附近的去耦。

LED 已集成在芯片中。手册第12页默认39 Ω支路为低压电源→P沟道MOS开关→39 Ω→LED_P，MOS型号 BSS223PWH6327XTSA1；20 Ω是另一条可选支路。首版可保留默认39 Ω支路并让其使能，按参考符号核对S/D/G脚序；不要把两条支路同时开启，也不要把39 Ω支路的电源改为3.3 V或5 V。若省掉MOS开关而永久供电，等效连接为1.9 V→39 Ω→LED_P，须在台架检查LED工作和跟踪质量。

## 3. 芯片逐脚连接

| PMW3360脚号 | 名称 | 原理图连接 |
|---:|---|---|
| 1、2、6、14、16 | NC | 悬空，不接地、不接电源 |
| 3 | VDDPIX | C3=4.7 µF与C4=100 nF分别接此脚到GND，两颗并联；不能接外部电源 |
| 4 | VDD | 接约1.9 V；C12=10 µF与C14=100 nF分别接此电源到GND，两颗并联，靠近芯片 |
| 5 | VDDIO | 接3.3 V；C23=10 µF与C24=100 nF分别接此电源到GND，两颗并联，靠近芯片 |
| 7 | NRESET | 内部弱上拉；建议额外10 kΩ上拉到3.3 V，留测试点/复位按键，按键接地 |
| 8 | GND | 公共地 |
| 9 | MOTION | 留测试点或可选连接器脚；首版轮询时无需接FPGA |
| 10 | SCLK | 外接SPI时钟 |
| 11 | MOSI | FPGA输出、芯片输入 |
| 12 | MISO | 芯片输出、FPGA输入；参考图有10 kΩ上拉到3.3 V |
| 13 | NCS | 低有效片选；建议10 kΩ上拉到3.3 V，避免主控未配置时浮空 |
| 15 | LED_P | 接上述LED供电支路 |

NCS与NRESET额外10 kΩ上拉属于本指南的设计建议。未使用的MOTION是输出，可保留测试点，不能接电源或地。芯片内有振荡器，无须给它增加50 MHz输入或外部晶振。

### 3.1 芯片电源电容明确清单

下表全部容量与连接均来自PMW3360手册第12页Figure 10。原图的PMW3360编号为U6；不要把LDO的OUT→FB前馈电容算作传感器对地去耦。

| 位置 | 电容与数量 | 两端连接 | 原图网络 |
|---|---|---|---|
| U6第3脚，VDDPIX | 4.7 µF ×1、100 nF ×1 | 每颗各自接VDDPIX与GND，两颗并联 | 内部LDO输出 |
| U6第4脚，VDD | 10 µF ×1、100 nF ×1 | 每颗各自接约1.9 V与GND，两颗并联 | VDD6_SS |
| U6第5脚，VDDIO | 10 µF ×1、100 nF ×1 | 每颗各自接3.3 V与GND，两颗并联 | VDD4_3.3V |

因此传感器侧这部分共6颗电容：4.7 µF一颗、10 µF两颗、100 nF三颗。LDO输入、LDO输出及OUT→FB前馈电容按第2节另计，不能因容量相同就删掉不同位置的元件。

画原理图时，两颗并联电容均是一端接对应电源、另一端接地，不串联，也不把VDDPIX接到外部1.9 V或3.3 V。100 nF=0.1 µF。

本板选料与布局建议：上述6颗优先用陶瓷X7R/X5R，统一选10 V耐压便于备料；原图明确C3为4.7 µF/10 V，其余统一10 V属于本板选料建议。100 nF优先贴近对应电源脚，µF级电容也放在同一电源脚附近，回地路径短。LDO旁的C21/C22与芯片旁的C12/C23是不同位置的电容；首版保留各自的位置。反馈前馈C20仍接OUT与FB，不接地。

琴弓PCB连接器可定义为 J_BOW：1=5V_IN、2=GND、3=SCLK、4=MOSI、5=MISO、6=NCS；这是新PCB自定义编号，不是底板排针编号。建议使用带锁扣和防反插的连接器，给线缆做应力释放，PCB丝印写清5V、GND和Pin 1。

## 4. Tang Mega NEO 底板实际接线

根据60K_31004图纸第19页及当前 constraints/tang_mega_60k.cst 第52–60行，可将工程已有SPI2接口作为候选：

| 琴弓PCB信号 | 底板物理针脚 | 底板网络 | FPGA封装管脚 | 当前工程端口 |
|---|---|---|---|---|
| 5V_IN | J13.11 | 5V_Peripheral | — | — |
| GND | J13.12 | GND | — | — |
| SCLK | J13.18 | SDRAM0_D8 | B21 | adc2_sck |
| MOSI | J13.17 | SDRAM0_D9 | A21 | adc2_mosi |
| MISO | J13.16 | SDRAM0_D10 | B20 | adc2_miso |
| NCS | J13.15 | SDRAM0_D11 | A20 | adc2_cs_n |

**B21等是FPGA封装管脚；实际插杜邦线的是J13的18/17/16/15脚。** 排针方向按PCB的Pin 1标识与图纸确定，不能仅凭照片左右推断。J13.11是5 V，不能误接芯片VDD或VDDIO。

该候选占用工程SPI2，前提是这组针脚没有接SDRAM或其他外设，且实际BANK2仍为默认3.3 V电源配置。本次只有图纸与约束证据，没有万用表测量证据。接线前核实这两个前提。J13是SDRAM0扩展，区别于与相机/PMOD1复用的SDRAM1。

J13没有默认可直接取用的3.3 V电源脚；J13.29/30默认是SDRAM_DM信号，其电源选配支路未装，不可当电源。若改成3.3 V输入的琴弓板，可以从PMOD0 J9.1/2取+3V3、J9.3/4取GND，再在琴弓板产生约1.9 V；该方案与本指南六线5 V方案二选一。

## 5. 为什么不能直接接板载USB

| 底板接口 | 图纸连接 | 与PMW3360的关系 |
|---|---|---|
| J7 USB-C | 第8页，BL616 USB-JTAG/UART | 调试口，无现成PMW3360 SPI转换功能 |
| P1 USB3 Type-C | 第20–21页，CH569 | 需要相应固件与FPGA接口，不能由换接头获得SPI |
| J18 USB-A | 第9页，SW4选择FPGA或BL616 | FPGA位置也只有D+/D−两根数据线，另两根是5V/GND，不足四线SPI |

60K图纸规定J18实体口使用USB_A2，USB_A1焊位默认NC；138K图纸中的默认焊位相反，不能混用。60K的SW4放在FPGA位置时，D+、D−分别到H13、G13，但当前项目没有USB Host/HID或USB到SPI桥接。

普通被动“杜邦线转USB”只有导线和接头，没有协议转换。可以在电压和供电方向确认后将USB当供电来源，但数据仍需独立SPI线。若希望成为标准USB设备，须增加有USB设备功能的MCU或专用桥接芯片，还要实现相应主机端接收；这会扩大当前设计范围。

## 6. PCB布局顺序

1. 先画芯片与实际镜头的机械封装、定位孔、光学窗口和安装孔，再确定板边。手册第4–10页给封装/镜头/装配图；板尺寸随实际琴弓结构确定，暂不编造尺寸。
2. 放置VDDPIX第3脚的4.7 µF与100 nF、VDD第4脚的10 µF与100 nF、VDDIO第5脚的10 µF与100 nF，均按第3.1节并联到地并靠近芯片。LDO输入、输出及OUT→FB前馈电容按第2节分别放在相应管脚附近，反馈线远离SPI时钟和LED电流路径。
3. 放置LED供电支路与连接器。低层面铺连续地，光学开孔处按机械禁布区处理；LED回流不要绕进VDDPIX去耦回路。
4. 走短SPI线，预留串联电阻调试焊盘与3.3 V、1.9 V、VDDPIX、NCS、SCLK、MISO、NRESET测试点。长线是否稳定必须实测；初次验证用短线和较低SPI频率。
5. 核对Pin 1、镜头方向、NC悬空、LDO封装脚序、输入5 V与两条低压网没有混接，再做EDA的ERC/DRC。焊接时保护光学窗口，避免助焊剂进入芯片与镜头。

## 7. FPGA驱动还需要补什么

手册第19–20页时序对应SPI Mode 3（CPOL=1、CPHA=1），MSB先传，第14页最大2 MHz。初次调试建议1 MHz。当前项目50 MHz系统时钟若半周期分频为25，就是1 MHz；半周期最小13才不超过2 MHz。

当前 spi_profile_bank 的默认值是Mode 0、半周期8个50 MHz周期（3.125 MHz），且三路默认禁用；不能拿默认配置直接驱动PMW3360。spi_master_runtime只提供1–32 bit命令后1–32 bit回读，不含PMW3360专用等待、SROM流和12字节运动报告。top当前把原始SPI数据送往UART诊断快照，未接入演奏仲裁。

需要建立专用驱动，至少包括：

- 上电/复位与≥50 ms等待；按手册第26页清读0x02–0x06。
- 普通寄存器读写：写地址最高位为1，读为0。普通读地址后≥160 µs；写结束片选保持、相邻事务间隔分别按第15–16、21页核对，不能依赖普通连续SPI默认行为。
- SROM加载：PDF只包含步骤，没有固件字节。向芯片供应商取得适配PMW3360的SROM文件与版本，加载后先读SROM_ID确认。第23页要求0x1D、等待10 ms、0x18启动；图22还规定下载字节间≥15 µs等时序。此流程需常驻在FPGA或启动配置流程中，芯片断电后不能假定固件仍在。
- Motion_Burst：先写Motion_Burst使能，读0x50后等待≥35 µs，连续读取最多12字节，结束片选高电平≥500 ns。报告含ΔX/ΔY、Motion、SQUAL等；ΔX/ΔY是低字节先、16位补码。
- 时间戳、采样有效性、抬起/跟踪失效与超时处理，避免无效数据持续注入弓能量。可把1 kHz轮询作为起始设计目标，不能把它当已测到的总延迟。

最初通路检查：读Product_ID(0x00)应为0x42、Inverse_Product_ID(0x3F)应为0xBD。ID成功只证明寄存器通信，不能证明SROM加载或光学跟踪。

## 8. 接入音乐项目时的量与验证顺序

项目 docs/revision6_sensor_contract_cn.md 的光学弓合同使用dx、dy、dt、contact、pressure、position、string_id。PMW3360提供相对运动；速度由主轴位移除以实测采样间隔得到，方向由主轴符号得到。毫米/秒换算要结合CPI设置和实物标定。

压力、接触与弦号需独立来源。可给后续压力传感/ADC或接触开关预留接口和安装位置；器件选型后再冻结模拟前端。SQUAL用于跟踪质量，不能当弓压；累加ΔX/ΔY也不能直接保证得到绝对接触位置或弦号。

先不接FPGA，用限流供电测两条LDO输出和短路情况；电源正确后再连接SPI，检查ID、SROM_ID和逻辑分析仪时序。然后在稳定纹理面上做双向匀速、停弓、过零、抬起、重新落下和失联测试。最后才接音乐控制，独立记录速度/压力/接触/弦选对音频的影响与动作到模拟输出的延迟。

当前结论为：芯片与板级连接已按资料核对，给出了可画板的候选方案；真实电气、光学跟踪、FPGA专用驱动与实物发声尚未闭合。本次未继承R6数字PASS来认证新传感器。

## 参考资料

- **PMW3360 数据手册** v1.50：重点第 3、4–12、14–16、19–23、26、30–33、51 页。
- **60K NEO 底板原理图**（31004）：重点第 8–9、19–21 页。
- **138K NEO 底板对照图**（31005）：仅作版本对照，不能替代 60K 的针脚定义。

以上三份资料未随本仓库分发，请从 PixArt 与 Gowin/Sipeed 官方渠道获取。
- [当前约束](../constraints/tang_mega_60k.cst)、[光学弓合同](revision6_sensor_contract_cn.md)、[通用SPI驱动](../src/spi_master_runtime.v)。
