jingchunqi09-sudo/Complexmusic/hardware/wiring.md

# 外设清单与接线

> **唯一权威来源**：`fpga/constraints/tang_mega_60k.cst`（引脚与 IO 标准）
> 与 `引脚表定案.md`（EC11 编码器，含实测反推过程）。
> 本文件是导读，如与 `.cst` 冲突，以 `.cst` 为准。

---

## 一、总表

| 外设 | 型号 / 规格 | 接口 | FPGA 引脚 | IO 标准 | 备注 |
|---|---|---|---|---|---|
| 系统时钟 | 50 MHz 晶振 | — | `V22` | LVCMOS33 | `clk_50m` |
| 复位按键 | Dock 用户键 0 | — | `AA13` | **LVCMOS15** | Bank9 是 1.5 V，勿接 3.3 V |
| 模式按键 | Dock 用户键 1 | — | `AB13` | **LVCMOS15** | 显示翻页 |
| 音频 DAC | PT8211（U16） | I2S | `Y17` BCK / `AB17` WS / `AA16` DIN | LVCMOS33 | `AB16` = 功放使能 `pa_en` |
| 弓传感器 | PAW3395（CN2） | SPI | `D19` NCS / `E19` MISO / `C19` MOSI / `C18` SCLK | LVCMOS33 | CN2 **不含** MOTION 与 NRESET |
| 左手电极 | ADC128S102 ×2（H4） | SPI mode-3 | `D15` SCLK / `C17` DIN / `A19` CS1 / `B17` CS2 / `A18` DOUT1 / `D17` DOUT2 | LVCMOS33 | 16 通道，5 ms 轮询 |
| 左手激励 | 4 路方波输出 | GPIO | `A21` TX1 / `B20` TX2 / `B18` TX3 / `B21` TX4 | LVCMOS33 | 载波激励电极 |
| 左手板选通 | 移位寄存器 | GPIO | `A20` SK_DATA / `A15` SK_CLK | LVCMOS33 | 电极板通道选通 |
| 压电 ADC | AD7091R-4（H6） | SPI | `B13` CS / `C13` SCLK / `A14` MOSI / `A13` MISO / `B16` CONVST / `B15` RESET / `A16` BUSY | LVCMOS33 | H6.1/2/10 为地，5 V 供电在 H5 |
| ESP32 | UART2 | UART | `E13` TX→ESP32 RX / `E14` RX←ESP32 TX | LVCMOS33 | 230400 8N1，经 R6/R5，**必须共地** |
| HDMI | NEO Dock J29 | DVI/TMDS | `J14,H14` D0 / `J15,H15` D1 / `K17,J17` D2 / `G15,G16` CLK / `K14` EN | 差分 | 与官方 60K cam_dvi 对齐 |

---

## 二、EC11 编码器面板（4 路）

**现行表（固件 3.5.10 起，实测定案）**：

| 编码器 | 功能 | A | B | SW |
|---|---|---:|---:|---:|
| ENC1（最左） | 音量 | 18 | 19 | 34 |
| ENC2 | 音色 | 23 | 25 | 35 |
| ENC3 | 定弦 / 换弦 | 26 | 27 | 36 |
| ENC4（最右） | 混响 | **33** | **32** | 39 |

按键低有效。排线为 **反序 1↔14**（`H9 pad k` 的网络名 = `U11 pin 15−k`）。

> **绝不要使用 3.5.8 之前的引脚表**（`4/5/13, 18/19/21, 22/23/25, 26/27/32`）。
> 其中 4/5/13 完全悬空，21/22 是 I2C 的 IMU_SDA/SCL，会导致四颗旋钮全部错位。

### 10 秒自检法

网页「面板接线自检」卡片 → 点「清零后监视」→ 转**最左**旋钮：

- 涨 `18 / 19` → 表正确（反序）；
- 涨 `39 / 33` → 排线是同向，需整组换成 `39/33/32, 36/27/26, 35/25/23, 34/19/18`；
- 再按一下最左旋钮：掉到 0 的是 `34` → 反序；是 `32` → 同向。

---

## 三、电源与电平注意事项

1. Dock 的 VCCIO1/2 默认 **3.3 V**；若做过 1.8 V 电阻改装，本设计不可直接用。
2. `reset_n` / `mode_n` 落在 **Bank9（1.5 V）**，不要接 3.3 V 信号。
3. HDMI 差分对 `DRIVE=3.5`、`PULL_MODE=NONE`，约束在 `.cst` 里，不要手改。
4. `uart_tx_o` / `uart_rx_i` 均设 `PULL_MODE=UP`：ESP32 复位期间 TX 可能悬空，
   上拉避免被误判为起始位。
5. 压电 5 V 供电走 **H5**，不是 H6；H6.1/H6.2/H6.10 是地。

---

## 四、上电接线检查清单

| # | 检查项 | 判据 |
|---|---|---|
| 1 | ESP32 与 FPGA 是否共地 | 万用表通断；**不通则一字节都收不到** |
| 2 | TX/RX 是否交叉 | ESP32 GPIO17 → E14（FPGA RX）；FPGA E13 → ESP32 GPIO16 |
| 3 | 面板排线方向 | 按第二节 10 秒自检法 |
| 4 | 压电模块供电 | H5 有 5 V |
| 5 | HDMI 线 | 用 Dock J29，非板载其他 HDMI 口 |
| 6 | 串口口号 | CH340 `1A86:7523`；排除 FT2232H `0403:6010` |

---

## 五、硬件设计文件在哪

| 内容 | 位置 | 说明 |
|---|---|---|
| **5 块自研板的 EDA 工程** | `自研板卡/*.epro2` | 嘉立创 EDA 专业版工程包，**已随包** |
| **3 份原理图 PDF** | `自研板卡/*.pdf` | 主控板 / 右手压电采集 / 左手 ADC 采集 |
| 琴弓模块 3D 结构 | `琴弓模块3D草稿/` | OpenSCAD 参数模型 + 四视图 + 尺寸表 |
| 琴弓 PCB 画板建议 | `琴弓PCB指南.md` | 光学结构、LDO、封装注意点（不含工程文件） |

> `.epro2` 是 zip 容器，内含 `project2.json` + `.epru` 设计数据 + 预览图。
> 用**嘉立创 EDA 专业版**「文件 → 打开工程」打开，可直接导出 Gerber / BOM / 坐标文件。

原项目中以下资料**未包含**在开源包内（体积大 / 第三方版权）：

| 资料 | 原位置 | 体积 |
|---|---|---|
| 芯片数据手册、第三方参考开源代码 | `官方资料/`（自研板卡已提取，见上） | 576 MB |
| ESP32 开发板资料包 | `官方资料/相关数据手册以及资料/` | 113 MB |
| 压电 HSPI 采集数据集 | `main_piezo_hspi_20261028/` | 1.07 GB |
| 左手外设实验工程 | `test_lefthand/`、`左手选品参考代码/` | 5.5 GB |

需要时请从原始项目目录获取。
