jingchunqi09-sudo/Complexmusic/hardware/left-panel-validation.md

> **来源与性质（编者注）**
>
> 本文档原为项目 `左手选品参考代码/README_先看这里.md`，该目录（705 MB）未随包分发。
>
> **目录名有误导**：它叫「左手选品参考代码」，实际内容是**左手板的外设验证工程**——
> SK9822 RGB 灯带逐灯测试、双片 ADC128S102 原码监视、LH3 串口协议，
> 解决的是「随机亮 / 错位 / 开机未清屏 / ADC 原码可否信」这类硬件问题。
> **它不是左手按品选弦的算法来源。**
>
> 主工程左手按品的参数真源是 `fpga/config/left_hand_detection.json`
> （生成 `src/left_hand_vote_config.vh`），与本文档是两套东西。
>
> **未分发的部分**：该工程的 RTL、位流（`LATEST.fs` 17 MB）、367 份审查记录。

# 左手板 R4：当前入口

更新时间：2026-10-25。Tang Mega 60K / GW5AT-60B / GW5AT-LV60PG484AC1/I0。

**本版修正RGB协议；你已确认R3的ADC正常，本版保留ADC和串口逻辑。R4已完成仿真和Gowin构建，尚未上板验证，不能称随机亮已经实板排除。**

## 只下载这一份

- 当前位流：本文件夹的 [LATEST.fs](LATEST.fs)。SHA256：`6404c97a86eda95ee844a481f02c98110846f43f7f86efd3d3e1078b435a4cf6`。
- Gowin Programmer 选择正确Tang Mega 60K设备，以 **SRAM Program** 下载这一份，暂不写Flash。不要按旧文件修改时间选版本。此位流同时包含ADC、串口和逐灯测试。
- R3回退保存在 [归档/before_r4_20261025/LATEST.fs](归档/before_r4_20261025/LATEST.fs)，旧hash `9bdd4ca9b330…`。
- 源码/工程仍在 [工程/left_hand_peripheral_test.gprj](工程/left_hand_peripheral_test.gprj)，没有另建第二个当前工程。

## 灯应怎样运行

上电最初约0.5秒重复全链清屏，之后以低亮度逐颗L1→L64走红色一轮，再绿色一轮、蓝色一轮，循环。每次换灯前完整OFF至少两帧，且OFF阶段至少100ms；ON阶段目标500ms，边界按完整帧取整。约0.64秒换一颗、约41秒走完64颗单色。不是整板同时全亮。

**每帧只允许1颗的1种颜色非零，电流码固定4，其余为合法OFF字E0000000。** 全链正常接收的三类数字模型中逐级更新最多1颗亮。码4的2.324mA是SK9822-001 B/1表值，实装批次和实际电流未测；整板还包括64颗灯IC静态电流和其他电路，不能把单色输出电流当整板限流。噪声、错位、开机未清屏的实际亮灯状态不受该数字结论保证。

本轮先核对资料：你已有PDF为SK9822-001 B/1（2025-08-13），另对照SK9822 Rev.01（2016-03-18）托管规格书。两份的管脚、BGR/MSB和32个1结束帧一致；R3没有发送该结束帧，R4已补齐，再附零提交/冲刷。厂家网站本次TLS验证失败，**没有宣称查到当前官网最新版，实装完整后缀/批次也未知**。详情和来源见 [R4审查结论](审查记录/rgb_r4_20261025/审查结论.md)。

## 在电脑看ADC原码与电压

1. 双击 [启动电压监视器.bat](启动电压监视器.bat)，浏览器地址通常为 http://127.0.0.1:18725/ ，占用时用18726。
2. 在网页选实际板卡USB接收串口，115200、8N1、无流控，点击“连接实测串口”。未自动打开或切换COM。
3. 第一部分为两片各8路的**原始ADC码**：DEC、HEX、12位BIN、UART低→高字节。第二部分为同一组码换算的V/ΔV与曲线，支持原码+电压CSV、原始接收字节导出。
4. 电压公式为 `code×VA/4096`，默认VA=3.300V、VCM=1.650V，按实测参考调整；改VA/VCM不会改原始码。无有效包不能冒充0V；软件演示不当作真实板卡数据。

监测软件版本名仍为 `left-hand-latest-20261024-r3-raw`，固件心跳格式仍为 `LH3`，**本轮没有改接收协议/界面**。这两个名字不能区分R3/R4位流，应核对上方SHA256。心跳中的灯目标是发送器内部状态，不是灯的回读。

启动失败窗口会停留，查看 `工程/pc/launcher.log`、`工程/pc/server.log` 或根 `startup_error.log`。启动器文件 `start_monitor.py` 请保留。

## 本版实际验证到哪里

- ADC主模型：477帧转换、53个真实TX解出的CRC合格包，全部16路含0/4095和四激励状态。
- R3/R4对照：926616拍，ADC端口、激励、16路快照和LH串口波形一致，包含转换中复位。RGB诊断目标字段另计。另复现并修复一帧内短复位请求丢失，保证完成在途帧后清屏。
- 三套64级RGB行为模型：全部192颜色/地址组合、回绕、在途reset、恢复，正常更新最多1颗。另跑默认50MHz/100kHz、500ms启动/500msON/100msOFF共58帧，源端建立/保持各5µs。
- 故意注入双灯数据与缺失END，都被检查器捕获；旧R3在严格END假设下未提交也已复现。模型不是厂家硅片模型。
- Gowin V1.9.12.03：50MHz目标、fmax66.590MHz、setup+4.983ns、hold+0.211ns、setup/hold违例端点0/0。PR1014通用时钟布线警告保留；ADC DOUT外部时序未签核。
- 本轮实际调用DeepSeek/千问三轮共6个完整API响应，逐条核验、反驳错误建议；没有把API意见或仿真PASS当实板成功。

**尚未验证R4实板扫描、实际5V/信号波形和供电电流。** 若仍随机亮或多颗高亮，先停止供电；按R4报告核对U10输出与L3→L4时钟/数据，不能无证据判焊接问题，也不要增大亮度。

## 源码、复现与归档

当前RTL是 `工程/rtl/left_hand_peripheral_test.v` 的RGB部分；ADC/UART/top/CST/SDC/PC保留。引脚仍为A15=SK_CLK、A20=SK_DATA，依据两份原图；图纸一致不等于实物导通已测。

- 主仿真：`工程/sim/run_modelsim.ps1`。
- 三类RGB链：`审查记录/rgb_r4_20261025/run_tests.ps1`。
- 新旧ADC/串口对照：`审查记录/rgb_r4_20261025/run_equivalence.ps1`。
- 注错检查：`审查记录/rgb_r4_20261025/run_mutations.py`。
- 构建：`工程/build_windows.ps1`；不会自动烧录或替换LATEST。
- 当前交付核验：`审查记录/核验当前交付.py`，检查实际源码/构建输入/位流和保存的验证证据。

[R4详细审查与来源](审查记录/rgb_r4_20261025/审查结论.md) · [新旧源码差异](审查记录/rgb_r4_20261025/r3_to_r4.diff) · [当前数字验证记录](审查记录/rgb_r4_20261025/qualification.json)。审查记录中r3/旧日期文件是历史资料，旧整包在归档，本README和LATEST.fs为当前入口。
