jingchunqi09-sudo/Complexmusic/CHANGELOG.md

# 更新日志

本项目以**位流版本号 `R<n>`** 迭代，2026-10-28 至 11-04 共 62 个版本。
完整清单（每个版本改了什么、为什么废弃）见 [`docs/version-history.md`](docs/version-history.md)。
此处只列里程碑。

版本号与 Git 标签的对应关系见 [`docs/version-history.md`](docs/version-history.md) 末节。

---

## R54 — 2026-11-03 ｜ **本仓库的位流与源码都是这一版**

- 新增尤克里里（lane 4..7）弦指引：曲谱事件落在 uke 弦时，屏幕画琥珀色弦线 + 空弦块，命中变绿。
- 修两处既有缺陷：
  - `g_xl/g_xr/g_yc` 由 reg 改 wire —— 原写法会推断出 latch，上电位置随机；
  - 网页 MIDI 分弦只认小提琴（`noteToString()` 只在 `st.tune[0..3]` 里找），uke 永远分不到 lane。
- 顶层端口零新增，未动音频链、选品链、灯带、链路寄存器。
- 配套固件：**3.5.10**（3.5.8 引脚表反序，四旋钮会错位）。

## R62b — 2026-11-04 ｜ 后续演进（不在本仓库源码内，仅作记录）

- 资源与时序优化：相位 32→24 位、乘法 32×32→16×17。
- CLS 25,832 → **25,585（86%）**；hold 0.172 → **0.183 ns**；系统 fmax 54.530 → **58.514 MHz**。
- 功能指标与 R62 相同：32 独立振荡单元、1,562,500 osc·Hz、演奏延迟 4.02 ms。

> **本仓库为什么停在 R54**：R54 是经用户实板反复验证、效果最佳的版本。R55~R62b 是之后的
> 演进——其中 R57/R58 实板更差已废弃，R59 修掉 MOT=0 导致的单弦自鸣，R60 起加入曲谱直控、
> R61 优化延迟、R62 提升吞吐量。这些版本的价值见下方里程碑，但**本仓库的源码与位流都锁定 R54**，
> 两者同版本、可直接对应。

---

## 里程碑节点

| 版本 | 日期 | 意义 |
|---|---|---|
| R24 | 10-31 | 弓速 L2 + 弓压 224 + 选弦投票，长期行为基准 |
| R33 | 11-02 | 曲谱指引首次上屏（ESP32 下发 → 品框高亮） |
| R40 | 11-02 | 极简录音抽头（8 位截断），解决 pcm 扇出导致的自鸣 |
| R41 | 11-02 | 呼吸灯；用户指定的回退基线 |
| **R54** | 11-03 | **尤克里里指引，实板效果最佳** |
| **R59** | 11-03 | **修复单弦持续自鸣的根因**（paw3395 的 MOT=0 分支不清 delta） |
| R60 | 11-03 | ESP32 触发式 17 步曲谱指引，新增 `REG_GUIDE_*` 寄存器 |
| R61 | 11-03 | 延迟优先，新增 `latency_profile.vh` 作为延迟参数唯一真源 |
| R62 | 11-04 | 吞吐量 32 单元（24 路加法合成 + 8 弦） |
| R62b | 11-04 | 资源时序优化 |

## 已废弃版本

R34（弦 2 乱响）、R38/R39（上电自鸣）、R42（无位流）、R44/R45（左手选品损坏）、
R47（一直有混响）、R52/R52b（S1 乱响）、R55/R56/R58（单弦自鸣）、
R57（给左手总线加负载，实板更差）。

废弃原因详见 [`docs/version-history.md`](docs/version-history.md)。
