jingchunqi09-sudo/Complexmusic/docs/version-history.md

# 版本历史：R5 → R62b

> 共 62 个版本，全部在 2026-10-28 ~ 2026-11-04 的 8 天内完成。
> 标记说明：★ = 实板验证正常；✗ = 已废弃（附原因）；无标记 = 未上板或仅内部验证。
> 原始实现报告（每版一个 `docs/implementation/rXX_YYYYMMDD/` 目录）**未随本仓库分发**，
> 本文件是它们的索引摘要。

---

## 阶段一：多弦与压电重构（R5 ~ R9，10-28 ~ 10-31）

| 版本 | 主题 | 状态 |
|---|---|---|
| R5 | 四弦独立 | — |
| R6 | 多品取最高，压电重构 | — |
| R7 | 压电 v3（上升速度判据），拉弓修复，舞台显示重做 | — |
| R8 | 右手瞬态核，低延迟演奏候选 | — |
| R9 | 左手精准判据，屏幕重设计（1440×900 舞台画面） | — |

关键转折：R7 把压电判据从「比值」改成「上升速度」（`e3>GATE 且 rise>e9`），
解决了静止时误触发；同时空弦掩码 `OPEN_BOW_MASK` 从 0001 扩到 1111，四弦空弦都能拉。

---

## 阶段二：演奏链打磨（R10 ~ R30，10-31 ~ 11-01）

| 版本 | 主题 | 状态 |
|---|---|---|
| R10 | 发声修复，弓速重写 | — |
| R11 | R8 瞬态核 + 低延迟 + R9 显示 | — |
| R11.1 | 弦序修正 | — |
| R11.2 | 左手选品、弓起音、显示三页 | — |
| R11.3 | 左手阈值落地 | — |
| R12 | 左手阈值归位（算法研究） | — |
| R13 | 音量提升、释放加严、选品解耦 | — |
| R14 | 音量软限幅、选品提亮 | — |
| R15 | 左手释放加严 | — |
| R16 | 弓离弦静音、压电选弦、力度曲线 | — |
| R17 | 右手 rh6 判据（拍琴身颤音） | — |
| R18 | 左手差分判据，小提琴选弦修复 | — |
| R19 | 左手回 R8 判据，ESP32 链路接入 | — |
| R20 | 连续音色，ESP32 音色控制 | — |
| R21 | 小提琴桥端 IIR | — |
| R22 | 小提琴弓位修正，资源优化 | — |
| R23 | 弓压随弓速，多弦运弓 | — |
| R24 | 弓速 L2，弓压 224，选弦投票 | ★ 长期基准 |
| R25 | ESP32 链路打通 | — |
| R26 | 恢复 R24 音频网表，上电静音 | — |
| R27 | 无链路（定位用） | — |
| R28 | 链路在、录音抽头断开 | — |
| R29 | 参数通路、无抽头 | ★ |
| R30~R32 | 链路三级：曲谱 / 音量 / 录音 | — |

关键转折：R24~R29 是一次漫长的「上电乱响」定位战役。最终确认不是链路本身，
而是 **pcm 的扇出与走线被改变**；解法是从下游已寄存输出 `pt8211_tx.o_frame_pcm` 取样。
这条教训后来写成了硬规则：**关键信号（pcm / gate_bus / i_fret_bus / selected_strings）
的消费者数量必须与基线逐项相同**。

---

## 阶段三：显示、灯带与音色（R33 ~ R49，11-02）

| 版本 | 主题 | 状态 |
|---|---|---|
| R33~R35 | 曲谱指引（ESP32 下发 → 屏幕画品框） | ★ |
| R36 | 音量搬入 DAC | ★ |
| R37 | 控制路线定稿，固件 3.1.0 | — |
| R38 | 录音回传 | ✗ 实板自鸣 |
| R39 | 发声隔离（pcm 不进链路模块） | ✗ 自鸣 |
| R40 | 极简录音（8 位截断抽头） | ★ |
| R41 | 呼吸灯 | ★ 用户指定基线 |
| R42 | 屏幕 v3 | ✗ 无位流 |
| R43 | 删除换乐器 | ★ |
| R44 | 左手灯加按品，音色增强 | ✗ 左手选品被拖坏 |
| R45 | 灯配色重做 | ✗ 同 R44 |
| R46 | 灯回退，接口修复选品 | ★ |
| R47 | 弓传感器自愈 | ✗ 一直有混响 |
| R48 | 音色可闻度（±9 dB） | — |
| R49 | 回退 R41，琴弓软恢复 | — |

关键教训（R44/R45）：只给灯接了一行 `.i_fret_bus(fret)`，就让布局漂移，
把左手选品拖坏，**整版作废**。此后确立规则：新增功能只能用本模块独立信号，
或从下游已寄存输出取样。

---

## 阶段四：稳定化与 R54（R50 ~ R54，11-03）

| 版本 | 主题 | 状态 |
|---|---|---|
| R50 | 灯带规则 | — |
| R51 | 灯带双乐器 | — |
| R52 | 选弦可控（网页选弦卡片） | ✗ S1 乱响（force mux 插进了发声门控） |
| R52b | 回退选弦 | ✗ 仍乱响 |
| R53 | 回退 R51，网页优化 | — |
| **R54** | **尤克里里弦指引 + 演示曲谱** | ★ **本包发布版本** |

R54 的内容：

- 曲谱事件 lane 4..7（尤克里里）时，屏幕画琥珀色弦线 + 空弦块，命中变绿；
- 修掉两处既有缺陷：`g_xl/g_xr/g_yc` 由 reg 改 wire（原来会推断出 latch，上电位置随机）；
  网页 MIDI 分弦只认小提琴（`noteToString()` 只在 `st.tune[0..3]` 里找）。
- 顶层端口零新增，未动音频链、选品链、灯带、链路寄存器。

R54 资源与时序（据发布报告）：hold 裕量 0.168 ns，CLS 约 25.1k，属可上板但偏紧。

---

## 阶段五：R54 之后的进阶（R55 ~ R62b，11-03 ~ 11-04）

| 版本 | 主题 | 状态 |
|---|---|---|
| R55 | 只指引尤克里里 | ✗ 自鸣 |
| R56 | 指引收尾修复 | ✗ 自鸣 |
| R57 | 以 R54 为基线，uke 双手指引 | ✗ **实板更差**：读左手总线加了 20 位 4 选 1 MUX，同 place CLS +278 |
| R58 | 指引零负载 | ✗ 仍自鸣 |
| **R59** | **修单弦持续自鸣** | ★ **根因修复** |
| R60 | ESP32 触发式曲谱指引（17 步） | ★ |
| R61 | 延迟优先（三通道 0.68/0.40/4.02 ms） | — |
| R62 | 吞吐量 32 单元（24 路加法合成 + 8 弦） | — |
| R62b | 资源时序优化（CLS 25,585 / hold 0.183） | — |

### R59：一个值得记住的 bug

**现象**：某根弦松手后还在持续响。

**根因**：`paw3395_driver.v` 在读 Motion 寄存器时，若 bit7（MOT）= 0 表示「本轮无位移」，
原代码直接跳去读 SQUAL，**`delta_x/delta_y` 保留了上一次运弓的大值**；
而 `S_QUALITY_WAIT` 无条件置 `sample_valid<=1`，于是 tracker 每 2 ms 收到一个
「位移 = 旧大值」的假样本 → `sum_sat` 恒大于 `CLOSE_TH(12)` → gate 电平永不清零 →
那根弦一直响。哪根弦由 `pick_r`（常驻不清零）上次锁定的结果决定。

两条保底同时失效：8 ms 看门狗只在 `sample_valid==0` 时计时；R49 的 ready 冻结
又把 `!ready → gate<=0` 拿掉了。

**判据**：一次「松手还响」= 这个 bug，不是 hold 违例、不是显示、不是选弦逻辑。

---

## 废弃版本汇总

| 版本 | 废弃原因 |
|---|---|
| R34 | 弦 2 乱响 |
| R38 / R39 | 上电自鸣（pcm 扇出被改变） |
| R42 | 无位流 |
| R44 / R45 | 左手选品损坏（关键信号加了负载） |
| R47 | 一直有混响 |
| R52 / R52b | S1 乱响（force mux 进了发声门控） |
| R55 / R56 / R58 | 单弦自鸣（R59 前的误判） |
| R57 | 修活小提琴指引，给左手总线加负载，实板效果更差 |

---

## 一句话总结这 8 天

三次同型事故（R38、R44、R57）都指向同一条规律：
**在这个设计里，"给关键信号多加一个消费者" 比 "写错一行逻辑" 危险得多。**
R54 之所以是效果最好的版本，不是因为它功能最多，而是因为它**没有动那些信号**。
