jingchunqi09-sudo/Complexmusic/hardware/boards/主控板.pdf

D23 15 EN 16 VP 17 VN 18 D34 19 D35 20 D32 21 D33 22 D25 23 D26 24 D27 25 D14 26 D12 27 D13 28 GND 29 VIN 30

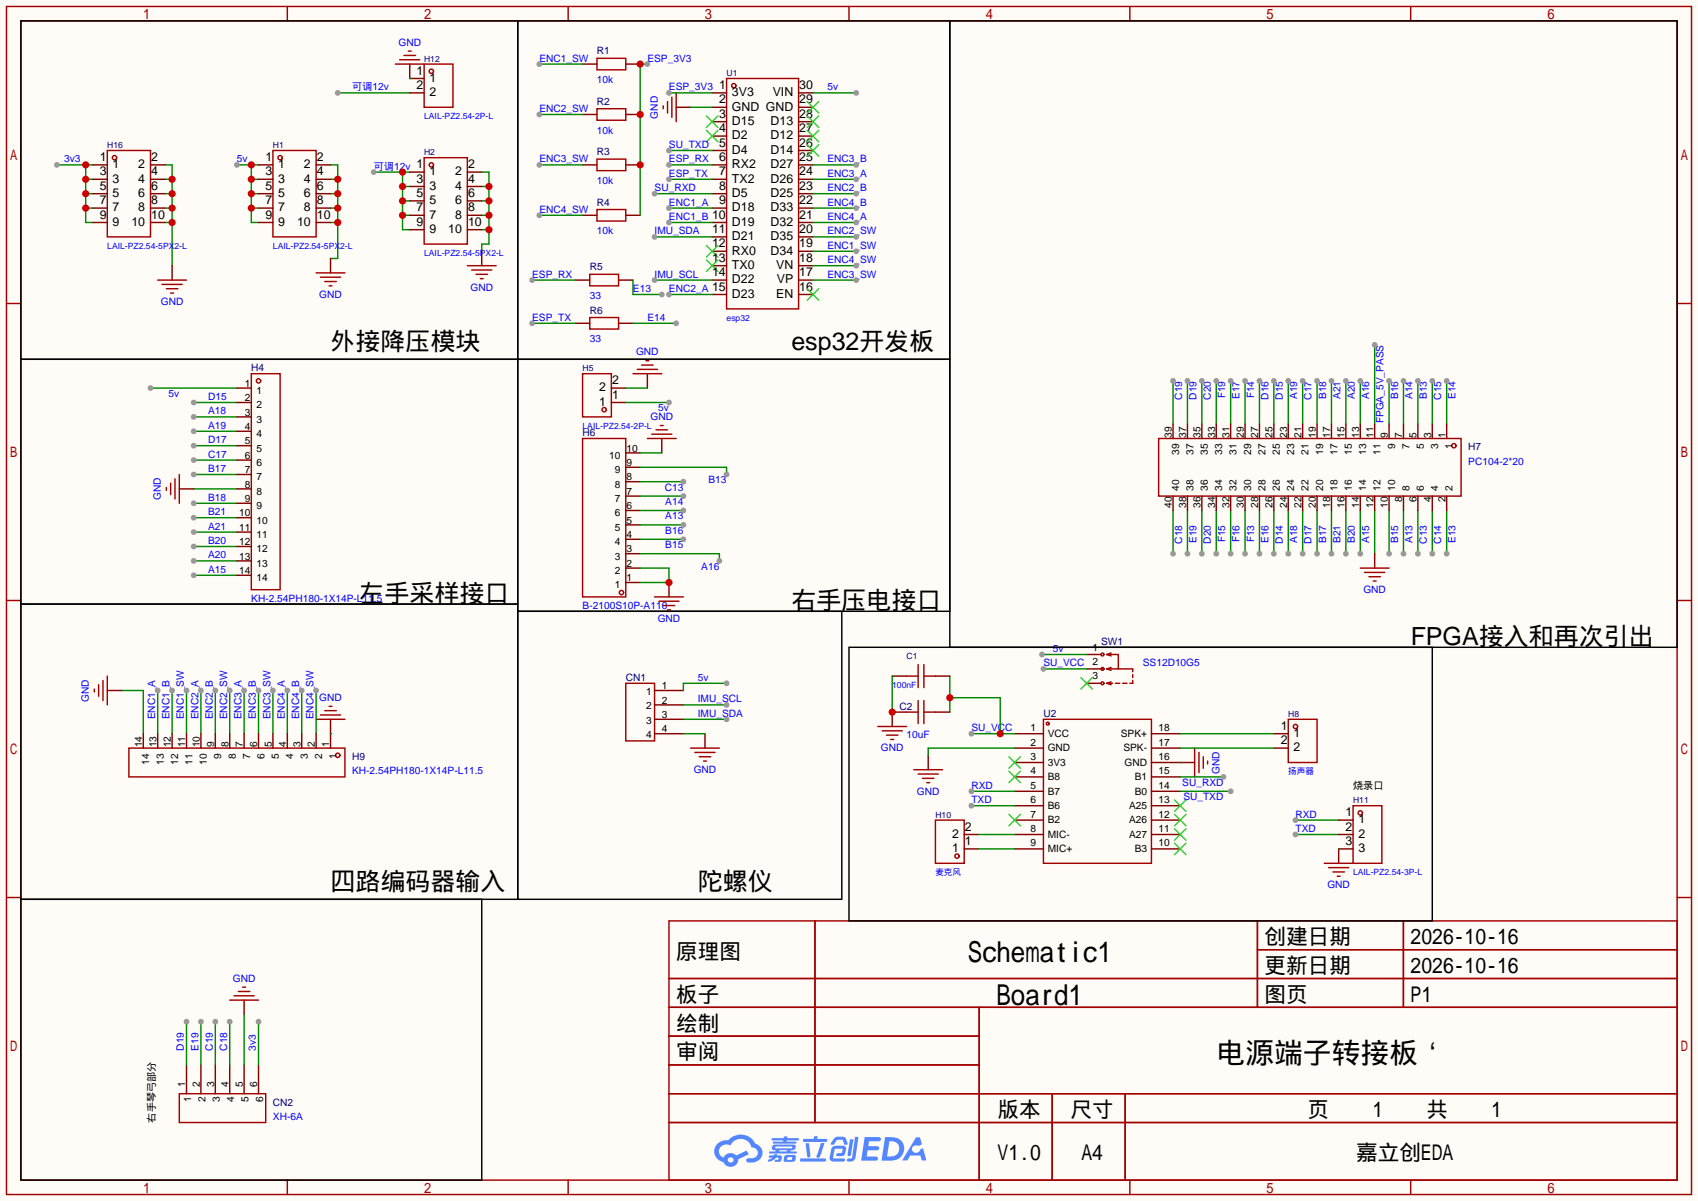
[picture p9: page 1]

原理图 | Schematic1 | 创建日期 | 2026-10-16

更新日期 | 2026-10-16

板子 | Board1 | 图页 | P1
绘制 | | 电源端子转接板‘
审阅

V1.0 | A4 | 嘉立创EDA
