jingchunqi09-sudo/Complexmusic/hardware/boards/右手压电陶瓷片采集.pdf

# 压电4的钳位和电压跟随

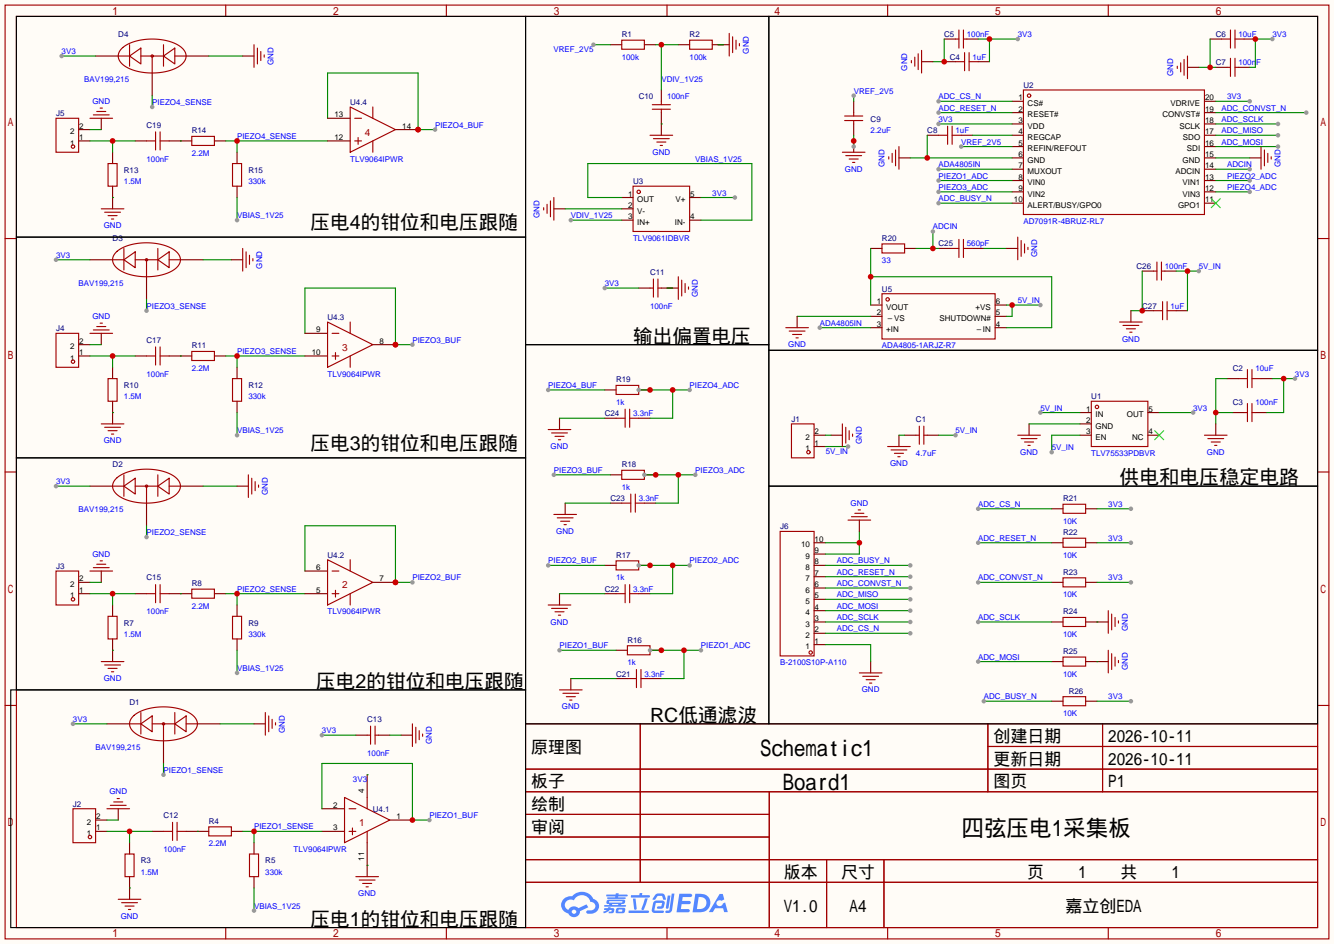
[picture p10: page 1]

原理图 | Schematic1 | 创建日期 | 2026-10-11

更新日期 | 2026-10-11

板子 | Board1 | 图页 | P1
绘制 | | 四弦压电1采集板
审阅

V1.0 | A4 | 嘉立创EDA
