jingchunqi09-sudo/Complexmusic/hardware/boards/左手adc采集.pdf

# 5V降3V3 +5V

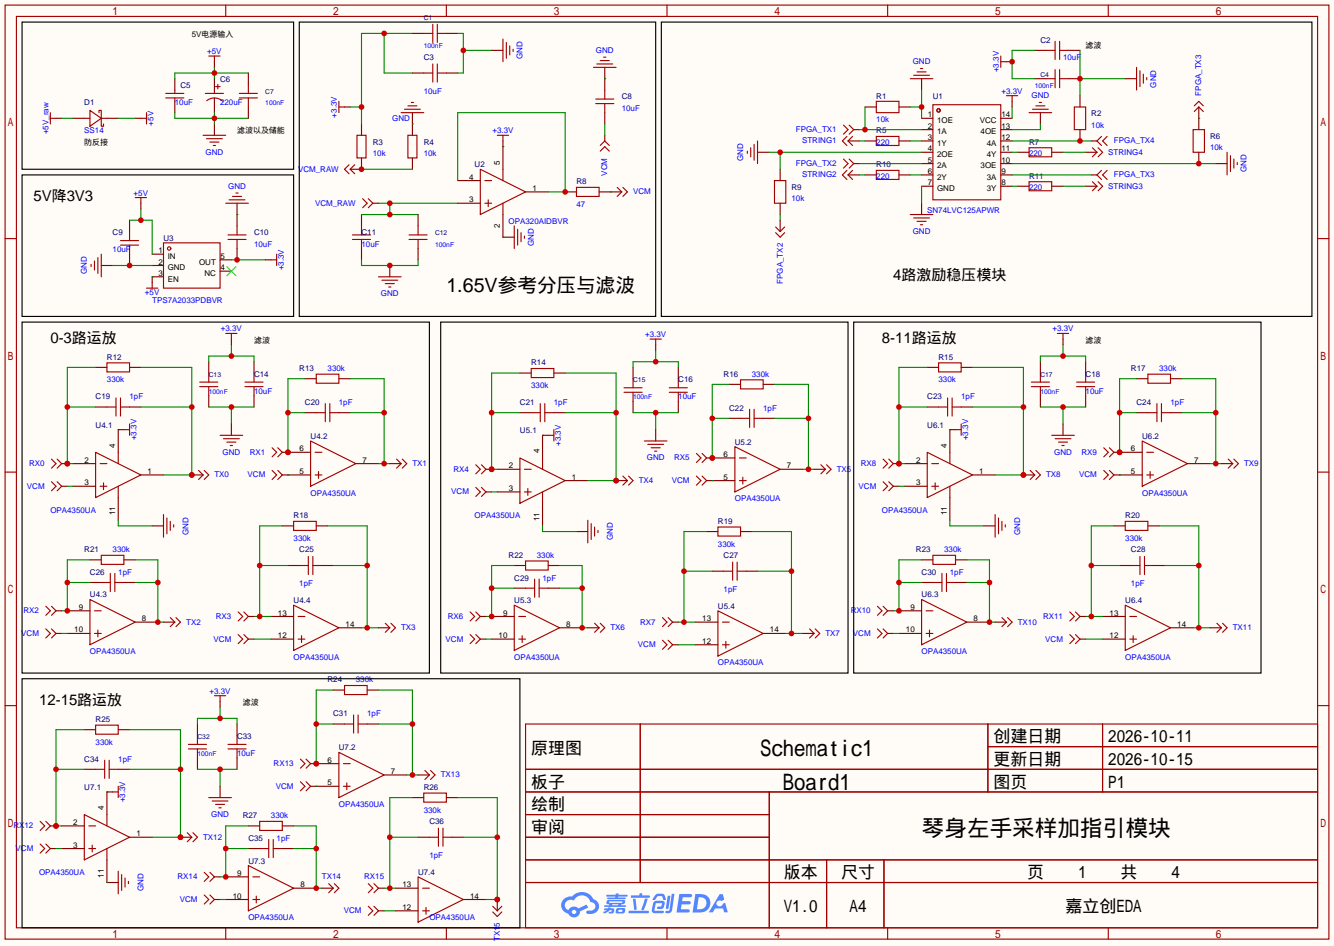
[picture p11: page 1]

板子 | Board1 | 图页 | P1
绘制 | | 琴身左手采样加指引模块
审阅

V1.0 | A4 | 嘉立创EDA

ADC采样芯片模块1 | ADC采样芯片模块2

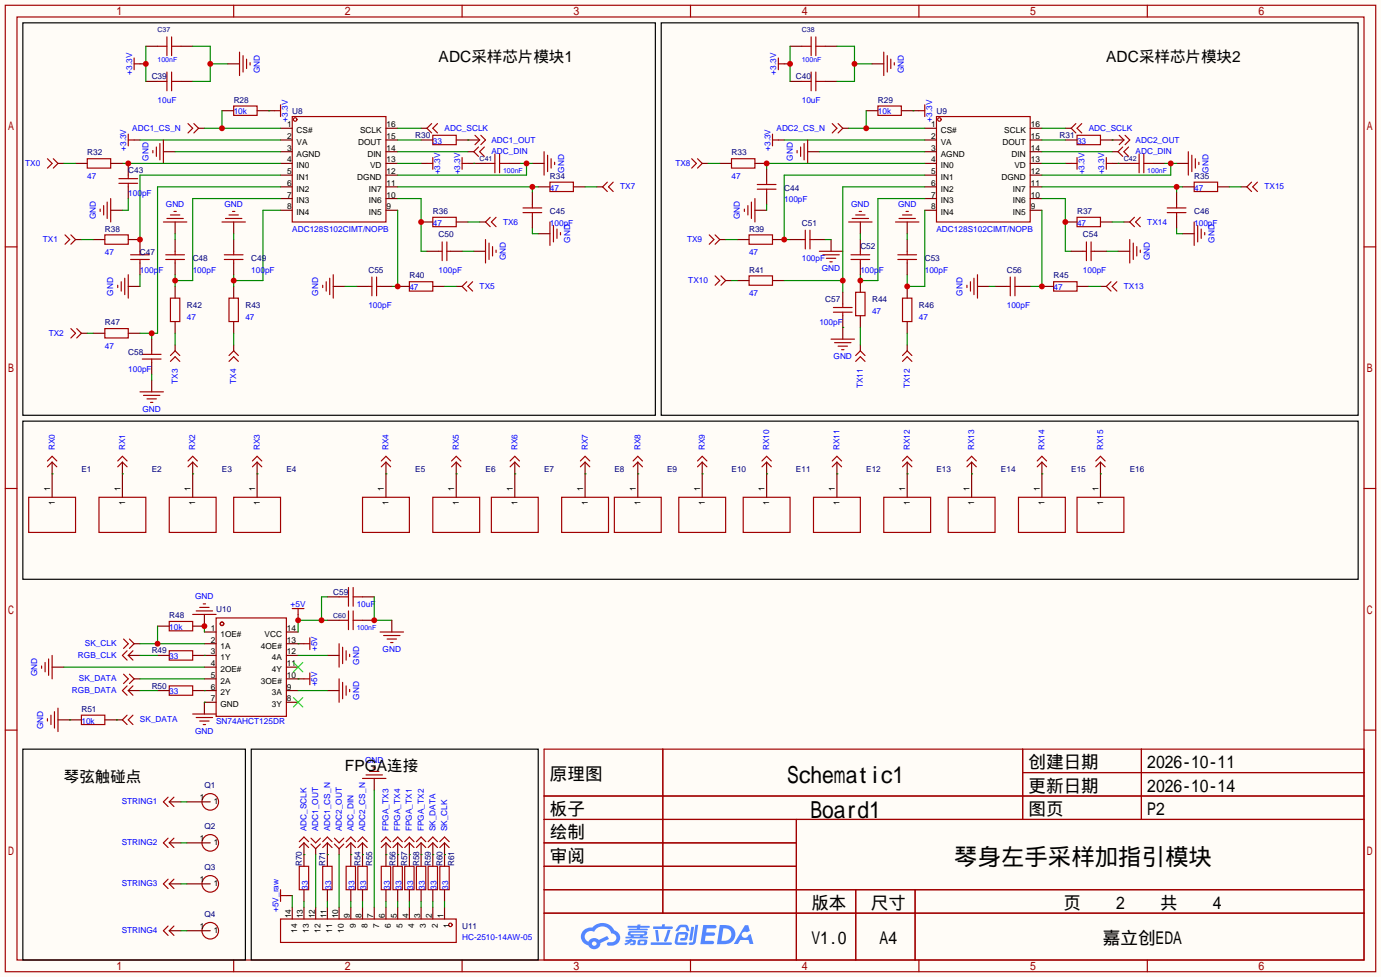
[picture p12: page 2]

原理图 | Schematic1 | 创建日期 | 2026-10-11

更新日期 | 2026-10-14

板子 | Board1 | 图页 | P2
绘制 | | 琴身左手采样加指引模块
审阅

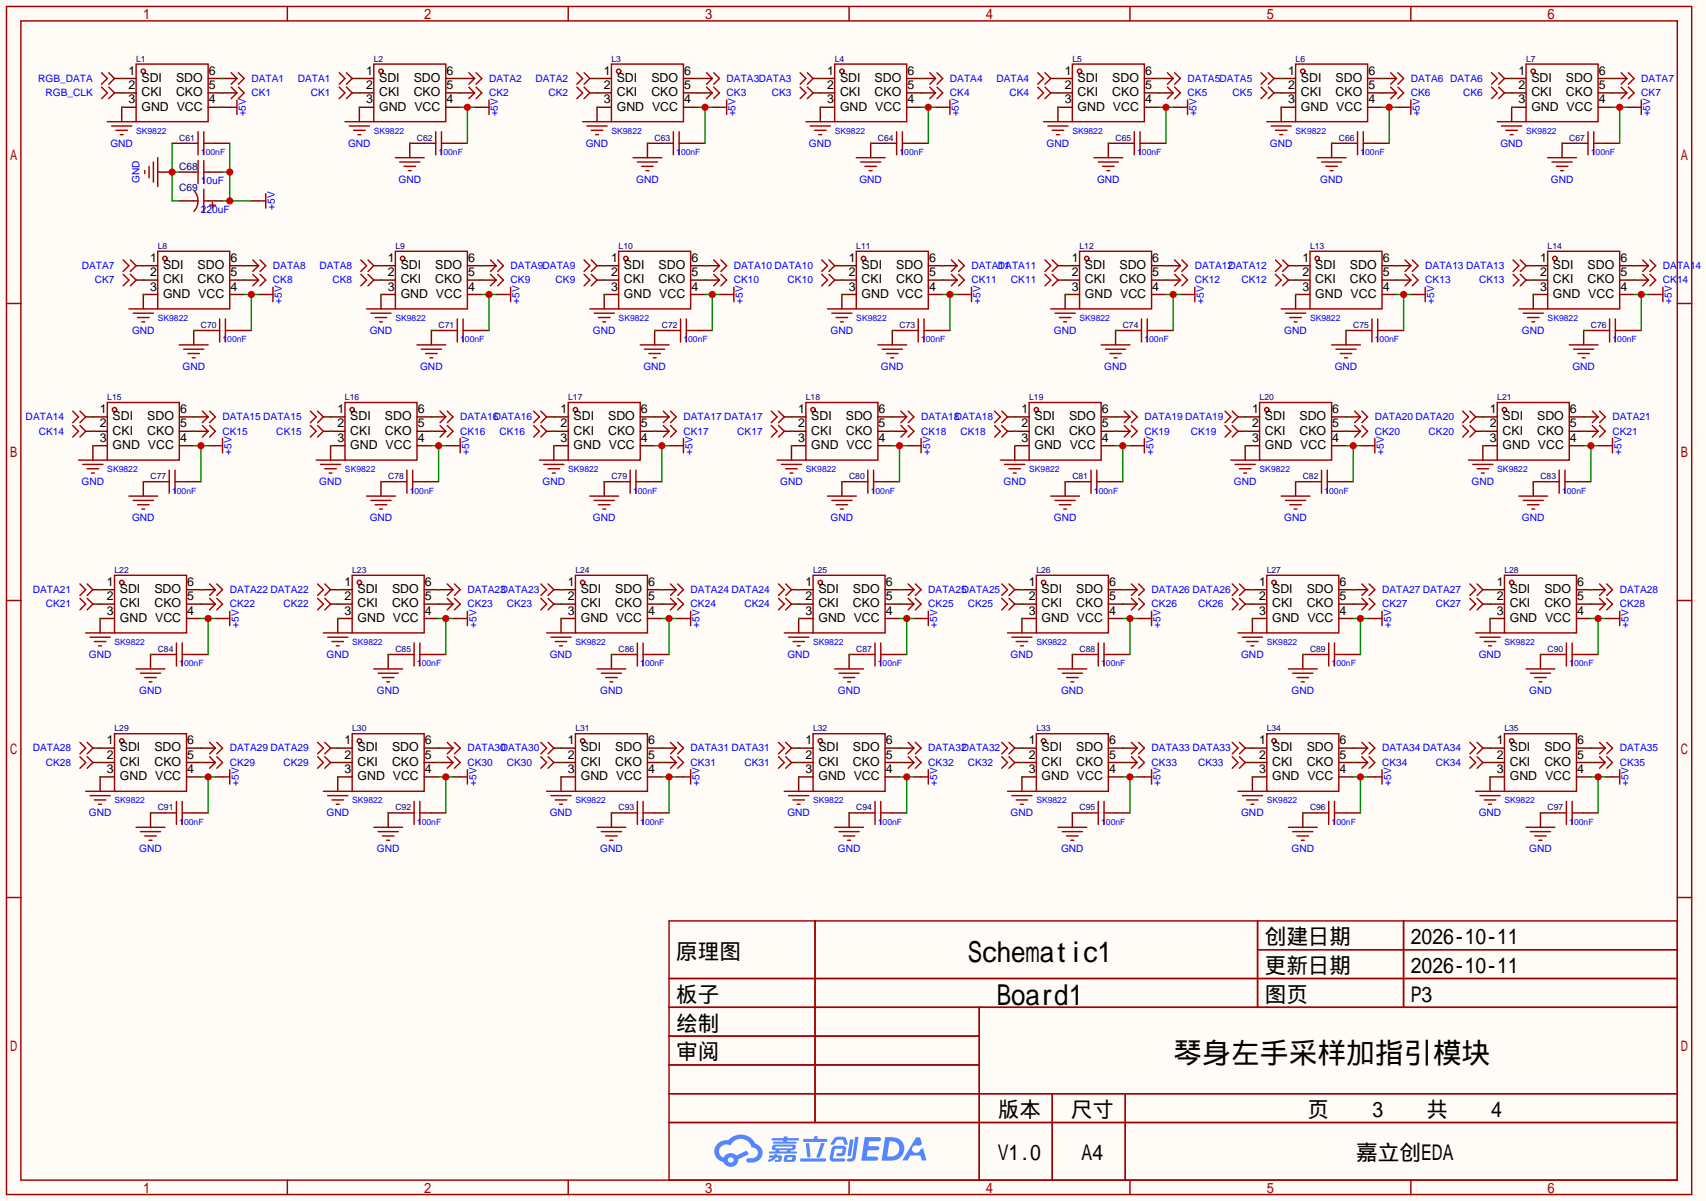
[picture p13: page 3]

原理图 | Schematic1 | 创建日期 | 2026-10-11

更新日期 | 2026-10-11

板子 | Board1 | 图页 | P3
绘制 | | 琴身左手采样加指引模块
审阅

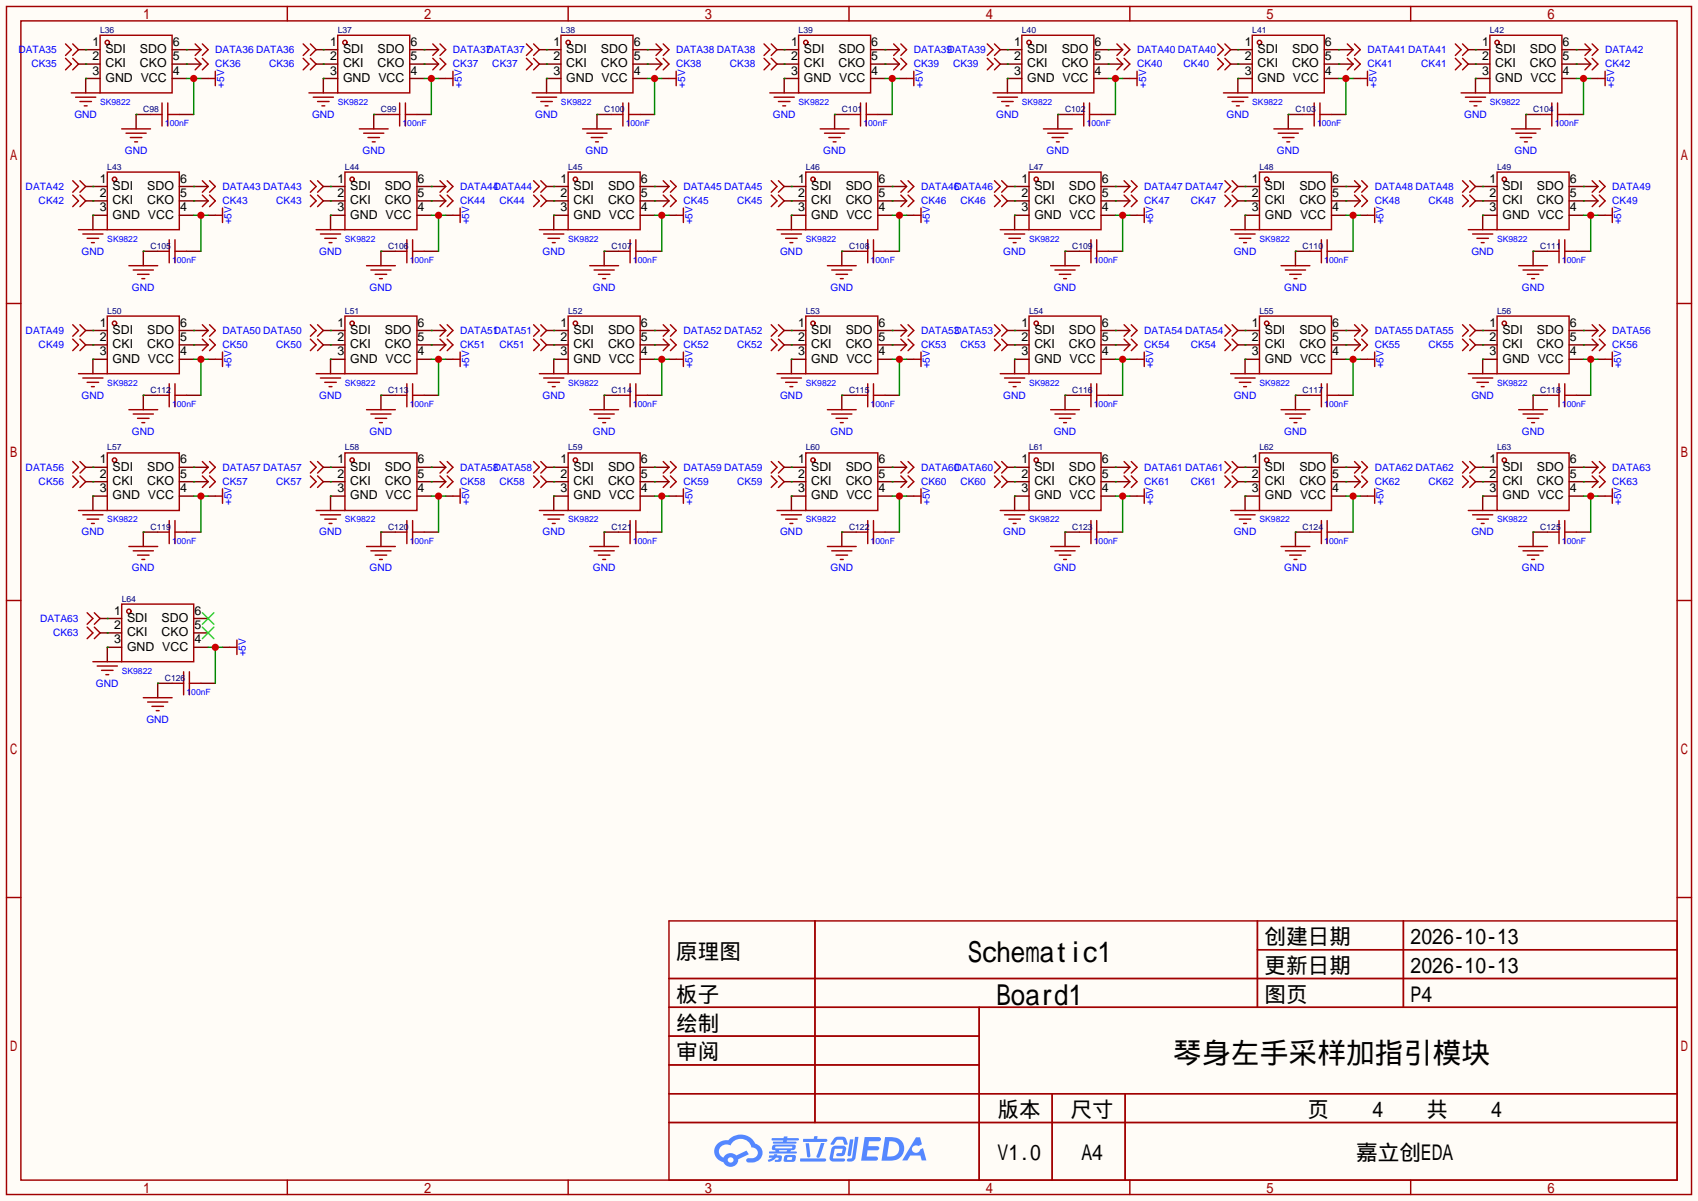
[picture p14: page 4]

原理图 | Schematic1 | 创建日期 | 2026-10-13

更新日期 | 2026-10-13

板子 | Board1 | 图页 | P4
绘制 | | 琴身左手采样加指引模块
审阅
