jingchunqi09-sudo/Complexmusic/fpga/src/paw3395_driver.v

`timescale 1ns/1ps
// PAW3395DM-T6QU driver for Tang Mega 60K.
// Implements the datasheet power-up sequence, the 0x6C poll,
// and motion polling of Delta_X/Y registers. NRESET is actively driven.
module paw3395_spi_engine #(
    parameter integer CLK_DIV = 5,
    parameter integer LEAD_CYCLES = 50,
    parameter integer SRAD_CYCLES = 100,
    parameter integer TRAIL_CYCLES = 250
)(
    input wire clk, input wire rst_n, input wire start, input wire write_op,
    input wire [7:0] addr, input wire [7:0] wdata, input wire miso,
    output reg ncs, output reg sclk, output reg mosi,
    output reg [7:0] rdata, output reg done, output reg busy
);
    localparam [3:0] E_IDLE=0,E_LEAD=1,E_SETUP=2,E_FALL=3,E_RISE=4,E_WAIT=5,E_DFALL=6,E_DRISE=7,E_TAIL=8;
    reg [3:0] state; reg [31:0] divcnt, waitcnt; reg [7:0] tx; reg [7:0] rx;
    reg [3:0] bitidx; reg read_mode; reg data_phase;
    always @(posedge clk) begin
        done <= 1'b0;
        if (!rst_n) begin
            state<=E_IDLE; ncs<=1'b1; sclk<=1'b1; mosi<=1'b0; rdata<=0; busy<=0;
            divcnt<=0; waitcnt<=0; tx<=0; rx<=0; bitidx<=0; read_mode<=0; data_phase<=0;
        end else if (state==E_IDLE) begin
            ncs<=1'b1; sclk<=1'b1; mosi<=1'b0; busy<=1'b0;
            if (start) begin
                ncs<=1'b0; busy<=1'b1; read_mode<=!write_op; data_phase<=1'b0;
                tx <= write_op ? (addr | 8'h80) : (addr & 8'h7F);
                bitidx<=7; divcnt<=0; waitcnt<=0; state<=E_LEAD;
            end
        end else if (state==E_LEAD || state==E_WAIT || state==E_TAIL) begin
            // Wait parameters are system-clock cycles, independent of SCLK divider.
            divcnt<=0;
            case(state)
                E_LEAD: if(waitcnt>=LEAD_CYCLES-1) begin waitcnt<=0;state<=E_FALL;end else waitcnt<=waitcnt+1;
                E_WAIT: if(waitcnt>=SRAD_CYCLES-1) begin waitcnt<=0;bitidx<=7;rx<=0;data_phase<=1;state<=E_DFALL;end else waitcnt<=waitcnt+1;
                E_TAIL: if(waitcnt>=TRAIL_CYCLES-1) begin ncs<=1;busy<=0;done<=1;state<=E_IDLE;end else waitcnt<=waitcnt+1;
            endcase
        end else if (divcnt < CLK_DIV-1) begin
            divcnt<=divcnt+1;
        end else begin
            divcnt<=0;
            case(state)
                // PAW3395 samples MOSI on rising SCLK and changes MISO on falling SCLK.
                // The reference MCU uses CPOL=1, CPHA=1 (SPI mode 3).
                E_FALL: begin mosi<=tx[bitidx]; sclk<=1'b0; state<=E_RISE; end
                E_RISE: begin
                    sclk<=1'b1;
                    if (bitidx!=0) begin bitidx<=bitidx-4'd1; state<=E_FALL; end
                    else if (!read_mode && !data_phase) begin
                        tx<=wdata; bitidx<=7; data_phase<=1'b1; state<=E_FALL;
                    end else if (read_mode && !data_phase) begin
                        waitcnt<=0; state<=E_WAIT;
                    end else begin
                        state<=E_TAIL; waitcnt<=0;
                    end
                end
                E_DFALL: begin sclk<=1'b0; state<=E_DRISE; end
                E_DRISE: begin
                    sclk<=1'b1;
                    rx[bitidx]<=miso;
                    if (bitidx!=0) begin bitidx<=bitidx-4'd1; state<=E_DFALL; end
                    else begin rdata<={rx[7:1],miso}; state<=E_TAIL; waitcnt<=0; end
                end
                default: state<=E_IDLE;
            endcase
        end
    end
endmodule

module paw3395_driver #(
    parameter integer RESET_CYCLES=50000,
    parameter integer POWER_WAIT_CYCLES=2500000,
    parameter integer WAIT_5MS_CYCLES=250000,
    parameter integer WAIT_1MS_CYCLES=50000,
    parameter integer SPI_CLK_DIV=25,
    parameter integer SPI_SRAD_CYCLES=100,
    parameter integer CPI=1000,
    parameter integer DISABLE_REST=1,
    // R47：进入 S_ERROR 后等待多久自动重试（默认 100 ms @ 50 MHz）。
    // 原来 S_ERROR 没有任何出口，SPI 抖一次就永久死机，只能按复位键。
    parameter integer RETRY_CYCLES=5000000,
    // R47：运行期自检允许"连续失败几次"才判错。1 = 老行为（错一次就死）。
    parameter integer CHECK_FAIL_MAX=3
)(
    input wire clk_50m, input wire reset_n, input wire paw_miso, input wire paw_motion,
    output reg paw_nreset, output wire paw_ncs, output wire paw_sclk, output wire paw_mosi,
    output reg signed [15:0] delta_x, output reg signed [15:0] delta_y,
    output reg motion_valid, output reg ready, output reg init_error,
    output reg [7:0] debug_product_id, debug_inverse_id, debug_motion, debug_squal,
    output reg [15:0] debug_cpi_x, debug_cpi_y,
    output reg [3:0] debug_error,
    // One-cycle strobe after the complete Motion/Delta/SQUAL poll.  This is
    // an internal sensor sample boundary; it is deliberately not a UART
    // event and is used by the physical bow adapter below.
    output reg sample_valid
);
    localparam [4:0] S_RESET=0,S_PWRWAIT=1,S_PWR_LAUNCH=2,S_PWR_CMD=3,S_PWR_WAIT=4,
                     S_INIT_CMD=5,S_INIT_LAUNCH=6,S_INIT_WAIT=7,S_POLL_WAIT=8,S_POLL_LAUNCH=9,
                     S_POLL_CMD=10,S_FINAL_CMD=11,S_FINAL_LAUNCH=12,S_FINAL_WAIT=13,S_READY=14,
                     S_CLEAR_CMD=15,S_CLEAR_LAUNCH=16,S_CLEAR_WAIT=17,S_MOTION_CMD=18,S_MOTION_SET=19,S_MOTION_LAUNCH=20,S_MOTION_WAIT=21,S_ERROR=22,
                     S_CHECK_CMD=23,S_CHECK_LAUNCH=24,S_CHECK_WAIT=25,S_QUALITY_CMD=26,S_QUALITY_LAUNCH=27,S_QUALITY_WAIT=28,
                     S_AWAKE_CMD=29,S_AWAKE_LAUNCH=30,S_AWAKE_WAIT=31;
    // Datasheet: resolution = (register value + 1) * 50 CPI.
    // CPI must be a multiple of 50 in the range 50..26000.
    localparam [15:0] CPI_SETTING = CPI / 50 - 1;
    reg [4:0] state; reg [31:0] count; reg [7:0] init_index; reg [5:0] poll_count; reg [3:0] final_index;
    reg spi_start, spi_write; reg [7:0] spi_addr, spi_wdata; wire spi_done, spi_busy; wire [7:0] spi_rdata;
    reg [7:0] dx_l, dy_l; reg [2:0] clear_index, motion_reg_index;
    reg [1:0] check_phase, check_index;
    // R47：不能用 count 做重试计时 —— 进入 S_ERROR 时 count 的值不可控
    // （各状态的 else 分支都在让它自增，可能是任意值）。必须独立计数并在入口清零。
    reg [22:0] retry_cnt;
    reg [1:0]  fail_streak;      // 运行期自检连续失败次数（0..3）
    reg check_failed;
    reg [1:0] awake_phase;
    reg [7:0] awake_value;
    // Periodic Motion polling also works when the optional MOTION wire is absent.

    paw3395_spi_engine #(.CLK_DIV(SPI_CLK_DIV),.SRAD_CYCLES(SPI_SRAD_CYCLES)) u_spi (
        .clk(clk_50m),.rst_n(reset_n),.start(spi_start),.write_op(spi_write),.addr(spi_addr),.wdata(spi_wdata),.miso(paw_miso),
        .ncs(paw_ncs),.sclk(paw_sclk),.mosi(paw_mosi),.rdata(spi_rdata),.done(spi_done),.busy(spi_busy));

    function [7:0] init_reg; input [7:0] i; begin init_reg=0; case(i)
              0: init_reg = 8'h7F;
              1: init_reg = 8'h40;
              2: init_reg = 8'h7F;
              3: init_reg = 8'h40;
              4: init_reg = 8'h7F;
              5: init_reg = 8'h55;
              6: init_reg = 8'h56;
              7: init_reg = 8'h57;
              8: init_reg = 8'h58;
              9: init_reg = 8'h7F;
              10: init_reg = 8'h42;
              11: init_reg = 8'h43;
              12: init_reg = 8'h4B;
              13: init_reg = 8'h4D;
              14: init_reg = 8'h53;
              15: init_reg = 8'h7F;
              16: init_reg = 8'h43;
              17: init_reg = 8'h44;
              18: init_reg = 8'h4D;
              19: init_reg = 8'h51;
              20: init_reg = 8'h53;
              21: init_reg = 8'h55;
              22: init_reg = 8'h5A;
              23: init_reg = 8'h5B;
              24: init_reg = 8'h61;
              25: init_reg = 8'h62;
              26: init_reg = 8'h6D;
              27: init_reg = 8'h6E;
              28: init_reg = 8'h70;
              29: init_reg = 8'h4A;
              30: init_reg = 8'h60;
              31: init_reg = 8'h7F;
              32: init_reg = 8'h6D;
              33: init_reg = 8'h6E;
              34: init_reg = 8'h6F;
              35: init_reg = 8'h53;
              36: init_reg = 8'h55;
              37: init_reg = 8'h7A;
              38: init_reg = 8'h7D;
              39: init_reg = 8'h7F;
              40: init_reg = 8'h41;
              41: init_reg = 8'h42;
              42: init_reg = 8'h43;
              43: init_reg = 8'h7F;
              44: init_reg = 8'h71;
              45: init_reg = 8'h7F;
              46: init_reg = 8'h62;
              47: init_reg = 8'h63;
              48: init_reg = 8'h65;
              49: init_reg = 8'h66;
              50: init_reg = 8'h67;
              51: init_reg = 8'h68;
              52: init_reg = 8'h69;
              53: init_reg = 8'h6A;
              54: init_reg = 8'h6C;
              55: init_reg = 8'h6D;
              56: init_reg = 8'h51;
              57: init_reg = 8'h53;
              58: init_reg = 8'h54;
              59: init_reg = 8'h71;
              60: init_reg = 8'h72;
              61: init_reg = 8'h73;
              62: init_reg = 8'h7F;
              63: init_reg = 8'h4A;
              64: init_reg = 8'h4C;
              65: init_reg = 8'h55;
              66: init_reg = 8'h7F;
              67: init_reg = 8'h4B;
              68: init_reg = 8'h4C;
              69: init_reg = 8'h61;
              70: init_reg = 8'h62;
              71: init_reg = 8'h63;
              72: init_reg = 8'h7F;
              73: init_reg = 8'h4C;
              74: init_reg = 8'h56;
              75: init_reg = 8'h41;
              76: init_reg = 8'h4D;
              77: init_reg = 8'h7F;
              78: init_reg = 8'h4A;
              79: init_reg = 8'h4B;
              80: init_reg = 8'h4C;
              81: init_reg = 8'h41;
              82: init_reg = 8'h55;
              83: init_reg = 8'h56;
              84: init_reg = 8'h49;
              85: init_reg = 8'h42;
              86: init_reg = 8'h43;
              87: init_reg = 8'h44;
              88: init_reg = 8'h54;
              89: init_reg = 8'h5A;
              90: init_reg = 8'h5F;
              91: init_reg = 8'h5B;
              92: init_reg = 8'h5E;
              93: init_reg = 8'h61;
              94: init_reg = 8'h62;
              95: init_reg = 8'h7F;
              96: init_reg = 8'h48;
              97: init_reg = 8'h4F;
              98: init_reg = 8'h52;
              99: init_reg = 8'h51;
              100: init_reg = 8'h54;
              101: init_reg = 8'h53;
              102: init_reg = 8'h56;
              103: init_reg = 8'h55;
              104: init_reg = 8'h58;
              105: init_reg = 8'h57;
              106: init_reg = 8'h5A;
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
              2: final_val = 8'h07;
              3: final_val = 8'h40;
              4: final_val = 8'h00;
              5: final_val = 8'h01;
              6: final_val = 8'h00;
              7: final_val = CPI_SETTING[7:0];
              8: final_val = CPI_SETTING[15:8];
              9: final_val = CPI_SETTING[7:0];
              10: final_val = CPI_SETTING[15:8];
              11: final_val = 8'h01;
              default: final_val=0; endcase end endfunction

    always @(posedge clk_50m) begin
        spi_start<=1'b0; motion_valid<=1'b0; sample_valid<=1'b0;
        if(!reset_n) begin
            state<=S_RESET; count<=0; init_index<=0; poll_count<=0; final_index<=0; clear_index<=0; motion_reg_index<=0;
            paw_nreset<=1'b0; delta_x<=0; delta_y<=0; dx_l<=0; dy_l<=0; ready<=1'b0; init_error<=1'b0;
            spi_write<=0; spi_addr<=0; spi_wdata<=0;
            debug_product_id<=0;debug_inverse_id<=0;debug_motion<=0;debug_squal<=0;
            debug_cpi_x<=0;debug_cpi_y<=0;debug_error<=0;
            sample_valid<=1'b0;
            check_phase<=0;check_index<=0;check_failed<=0;
            retry_cnt<=23'd0; fail_streak<=2'd0;
            awake_phase<=0;awake_value<=0;
        end else begin
            // Keep the poll timer running during the SPI read as well as waiting.
            // Thus consecutive 0x6C reads start 1ms apart (datasheet +/-1%).
            if(state==S_POLL_WAIT || state==S_POLL_LAUNCH || state==S_POLL_CMD)
                count<=count+1;
            case(state)
                S_RESET: begin paw_nreset<=1'b0; ready<=1'b0; if(count>=RESET_CYCLES-1) begin count<=0; paw_nreset<=1'b1; state<=S_PWRWAIT; end else count<=count+1; end
                S_PWRWAIT: begin if(count>=POWER_WAIT_CYCLES-1) begin count<=0; spi_write<=1; spi_addr<=8'h3A; spi_wdata<=8'h5A; state<=S_PWR_LAUNCH; end else count<=count+1; end
                S_PWR_LAUNCH: begin spi_start<=1'b1; state<=S_PWR_CMD; end
                S_PWR_CMD: begin if(spi_done) begin count<=0; state<=S_PWR_WAIT; end end
                S_PWR_WAIT: begin if(count>=WAIT_5MS_CYCLES-1) begin count<=0;init_index<=0;check_phase<=0;check_index<=0;state<=S_CHECK_CMD;end else count<=count+1;end
                S_INIT_CMD: begin spi_write<=1; spi_addr<=init_reg(init_index); spi_wdata<=init_val(init_index); state<=S_INIT_LAUNCH; end
                S_INIT_LAUNCH: begin spi_start<=1'b1; state<=S_INIT_WAIT; end
                S_INIT_WAIT: begin if(spi_done) begin if(init_index==8'd139) begin count<=0;poll_count<=0;state<=S_POLL_WAIT;end else begin init_index<=init_index+8'd1; state<=S_INIT_CMD; end end end
                S_CLEAR_CMD: begin spi_write<=0; spi_addr<=8'h02 + {5'd0,clear_index}; state<=S_CLEAR_LAUNCH; end
                S_CLEAR_LAUNCH: begin spi_start<=1'b1; state<=S_CLEAR_WAIT; end
                S_CLEAR_WAIT: begin if(spi_done) begin if(clear_index==3'd4) begin check_phase<=1;check_index<=0;check_failed<=0;state<=S_CHECK_CMD;end else begin clear_index<=clear_index+3'd1; state<=S_CLEAR_CMD; end end end
                S_POLL_WAIT: begin if(count>=WAIT_1MS_CYCLES-1) begin count<=0; spi_write<=0; spi_addr<=8'h6C; state<=S_POLL_LAUNCH; end end
                S_POLL_LAUNCH: begin spi_start<=1'b1; state<=S_POLL_CMD; end
                S_POLL_CMD: begin if(spi_done) begin if(spi_rdata==8'h80) begin final_index<=0;state<=S_FINAL_CMD;end else if(poll_count>=6'd59) begin init_error<=1;ready<=0;debug_error<=2;retry_cnt<=23'd0;state<=S_ERROR;end else begin poll_count<=poll_count+6'd1;state<=S_POLL_WAIT;end end end
                S_FINAL_CMD: begin spi_write<=1; spi_addr<=final_reg(final_index); spi_wdata<=final_val(final_index); state<=S_FINAL_LAUNCH; end
                S_FINAL_LAUNCH: begin spi_start<=1'b1; state<=S_FINAL_WAIT; end
                S_FINAL_WAIT: begin if(spi_done) begin if(final_index==4'd11) begin
                    if(DISABLE_REST) begin awake_phase<=0;state<=S_AWAKE_CMD;end
                    else begin clear_index<=0;state<=S_CLEAR_CMD;end
                end else begin final_index<=final_index+4'd1;state<=S_FINAL_CMD;end end end
                // Datasheet 8.3: preserve reserved bits when changing AWAKE.
                // Read 0x40, set bit7, write, then verify before allowing READY.
                S_AWAKE_CMD: begin spi_addr<=8'h40;spi_write<=awake_phase==1;spi_wdata<=awake_value;state<=S_AWAKE_LAUNCH;end
                S_AWAKE_LAUNCH: begin spi_start<=1;state<=S_AWAKE_WAIT;end
                S_AWAKE_WAIT: if(spi_done) begin
                    if(awake_phase==0) begin awake_value<=spi_rdata|8'h80;awake_phase<=1;state<=S_AWAKE_CMD;end
                    else if(awake_phase==1) begin awake_phase<=2;state<=S_AWAKE_CMD;end
                    else if(spi_rdata!=awake_value) begin init_error<=1;ready<=0;debug_error<=5;retry_cnt<=23'd0;state<=S_ERROR;end
                    else begin clear_index<=0;state<=S_CLEAR_CMD;end
                end
                S_CHECK_CMD: begin
                    spi_write<=0;
                    if(check_phase==1) spi_addr<=8'h48+check_index;
                    else spi_addr<=check_index==0 ? 8'h00 : 8'h5F;
                    state<=S_CHECK_LAUNCH;
                end
                S_CHECK_LAUNCH: begin spi_start<=1;state<=S_CHECK_WAIT;end
                S_CHECK_WAIT: if(spi_done) begin
                    if(check_phase==1) begin
                        case(check_index)
                            0: debug_cpi_x[7:0]<=spi_rdata;
                            1: debug_cpi_x[15:8]<=spi_rdata;
                            2: debug_cpi_y[7:0]<=spi_rdata;
                            3: debug_cpi_y[15:8]<=spi_rdata;
                        endcase
                        if(spi_rdata != (check_index[0] ? CPI_SETTING[15:8] : CPI_SETTING[7:0])) check_failed<=1;
                        if(check_index==3) begin
                            if(check_failed || spi_rdata!=CPI_SETTING[15:8]) begin
                                // R47：初始化阶段（check_phase==1）错一次就判错 —— 配置没写对；
                                //      运行期（check_phase==2）要连续 CHECK_FAIL_MAX 次才判错，
                                //      单次 SPI 抖动只丢一个采样，不再整机死。
                                if(check_phase==1 || fail_streak>=CHECK_FAIL_MAX-1) begin
                                    init_error<=1;ready<=0;debug_error<=3;
                                    retry_cnt<=23'd0;state<=S_ERROR;
                                end else begin
                                    fail_streak<=fail_streak+2'd1;
                                    ready<=1;count<=0;state<=S_READY;
                                end
                            end else begin
                                fail_streak<=2'd0;init_error<=0;
                                ready<=1;count<=0;state<=S_READY;
                            end
                        end else begin check_index<=check_index+2'd1;state<=S_CHECK_CMD;end
                    end else if(check_index==0) begin
                        debug_product_id<=spi_rdata;check_index<=1;state<=S_CHECK_CMD;
                    end else begin
                        debug_inverse_id<=spi_rdata;
                        // 运行期自检实际读的是 Product_ID(0x00) + Inverse_ID(0x5F)，
                        // **不是 CPI**（CPI 只在初始化 check_phase==1 时核对）。
                        // 实测确认：ph=2 只读到 idx=0/1 就回 S_MOTION_SET，从不到 idx=3。
                        if(debug_product_id!=8'h51 || spi_rdata!=8'hAE) begin
                            // R47：初始化阶段严格；运行期连续 CHECK_FAIL_MAX 次才判错，
                            // 单次 MISO 抖动只丢一个采样，不再整机死。
                            if(check_phase==0 || fail_streak>=CHECK_FAIL_MAX-1) begin
                                init_error<=1;ready<=0;
                                debug_error<=check_phase==0 ? 1 : 4;
                                retry_cnt<=23'd0;state<=S_ERROR;
                            end else begin
                                fail_streak<=fail_streak+2'd1;
                                ready<=1;
                                motion_reg_index<=0;state<=S_MOTION_SET;
                            end
                        end else if(check_phase==0) begin
                            fail_streak<=2'd0;
                            state<=S_INIT_CMD;
                        end else begin
                            fail_streak<=2'd0;init_error<=0;
                            motion_reg_index<=0;state<=S_MOTION_SET;
                        end
                    end
                end
                S_READY: begin state<=S_MOTION_CMD; end
                // R47：原来这里没有任何出口 —— 一旦进来只能按复位键。
                // 现在等 RETRY_CYCLES（默认 100 ms）后回 S_RESET，
                // 重发 0x3A Power_Up_Reset 并重跑全部 140 条初始化，
                // 能清掉传感器内部状态（例如掉电后回默认 800 CPI 的情况）。
                // 重试期间 init_error 保持 1，下游 ready=0（弓速/弓位冻结、弓奏静音），
                // 恢复后 ready 自己回 1，下游会重新起音。
                S_ERROR: begin
                    ready<=1'b0;
                    if(retry_cnt>=RETRY_CYCLES-1) begin
                        retry_cnt<=23'd0; count<=0;
                        init_error<=1'b0; check_failed<=1'b0; fail_streak<=2'd0;
                        check_phase<=0; check_index<=0;
                        poll_count<=0; init_index<=0; final_index<=0;
                        state<=S_RESET;
                    end else begin
                        retry_cnt<=retry_cnt+23'd1;
                    end
                end
                S_MOTION_CMD: begin
                    if(count>=WAIT_1MS_CYCLES-1) begin
                        count<=0;check_phase<=2;check_index<=0;
                        // R47：运行期每轮必须清掉，否则一次抖动会把 check_failed
                        // 永久留在 1，之后每次检查都必判错 -> 必然进 S_ERROR 死锁。
                        check_failed<=1'b0;
                        state<=S_CHECK_CMD;
                    end else count<=count+1;
                end
                // Reading Motion (0x02) first freezes all four Delta bytes.
                S_MOTION_SET: begin spi_write<=0; spi_addr<=8'h02 + {5'd0,motion_reg_index}; state<=S_MOTION_LAUNCH; end
                S_MOTION_LAUNCH: begin spi_start<=1'b1; state<=S_MOTION_WAIT; end
                S_MOTION_WAIT: begin
                    if(spi_done) begin
                        case(motion_reg_index)
                            0: begin
                                debug_motion<=spi_rdata;
                                if (spi_rdata[7]) begin motion_reg_index<=1; state<=S_MOTION_SET; end
                                else state<=S_QUALITY_CMD;
                            end
                            1: begin dx_l<=spi_rdata; motion_reg_index<=2; state<=S_MOTION_SET; end
                            2: begin delta_x<={spi_rdata,dx_l}; motion_reg_index<=3; state<=S_MOTION_SET; end
                            3: begin dy_l<=spi_rdata; motion_reg_index<=4; state<=S_MOTION_SET; end
                            4: begin delta_y<={spi_rdata,dy_l};motion_valid<=!debug_motion[3];state<=S_QUALITY_CMD;end
                        endcase
                    end
                end
                S_QUALITY_CMD: begin spi_write<=0;spi_addr<=8'h07;state<=S_QUALITY_LAUNCH;end
                S_QUALITY_LAUNCH: begin spi_start<=1;state<=S_QUALITY_WAIT;end
                S_QUALITY_WAIT: if(spi_done) begin debug_squal<=spi_rdata;sample_valid<=1'b1;count<=0;state<=S_MOTION_CMD;end
                default: state<=S_RESET;
            endcase
        end
    end
endmodule
