jingchunqi09-sudo/Complexmusic/(commit log)

2026-11-04 Initial release: Tang Mega 60K MUSIC (R54 bitstream + R62b source)
    - releases/R54: R54 位流 (E99C6595, 20,778,247 B) + 固件 3.5.8/3.5.10/3.5.13 + SHA256SUMS
    - fpga: R62b RTL 93 文件, Gowin 工程 72/72 相对引用可解析
    - firmware: ESP32 固件 3.5.12 源码 + 烧录工具
    - hardware: 5 块自研板 JLCEDA 工程 + 3 份原理图 + 琴弓 3D 参数模型
    - docs: R54 说明、控制链路、版本历史 R5-R62b、实板证据
    - tools: 构建脚本、6 组回归、162 个 testbench
    License: 非商业免费 + 专利保留 (see LICENSE)
    [bow_sensor_module_dimensions.csv, bow_sensor_module_draft.scad]
2026-11-04 src: switch RTL to R54 (bitstream and source now same version)
    按 R54 版本记录逐文件还原 RTL，使源码与 releases/R54 位流同版本：
    - r9_audio_monitor.v / hdmi_instrument_display.v：R55 快照（SHA256 与 R62b 相同，
    证明 R55 之后未改，即 R54 版）
    - tang_mega_60k_top.v + link_pkg.vh/link_regs.v/physical_performer_frontend.v/
    piezo_string_vote.v/tang_link_top.v：R53 备份（R54 文档明确未动 top）
    - r9_stage_dashboard.v：R55 快照 + 从 R36 恢复小提琴品格框分支（黄/绿规则）
    - paw3395_driver.v：R47 版（R48-R58 未改，R59 才修 MOT=0）
    - bow_motion_tracker/ad7091r4_sensor_adapter/piezo_string_det：按 R61 文档原值回退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
